oktaycit/CNCRevizyon/Documentation/Media/YerlikayaSürücüler.jpeg

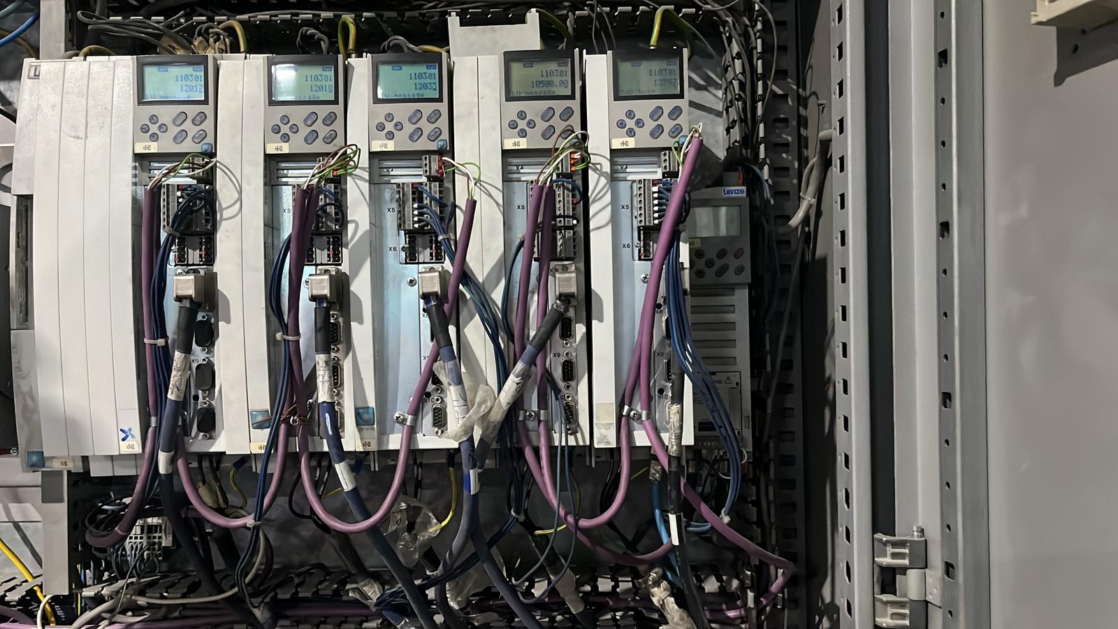
Documentation/Media/YerlikayaSürücüler.jpeg
