oktaycit/CNCRevizyon/Documentation/Media/WhatsApp Image 2026-04-01 at 16.56.13.jpeg

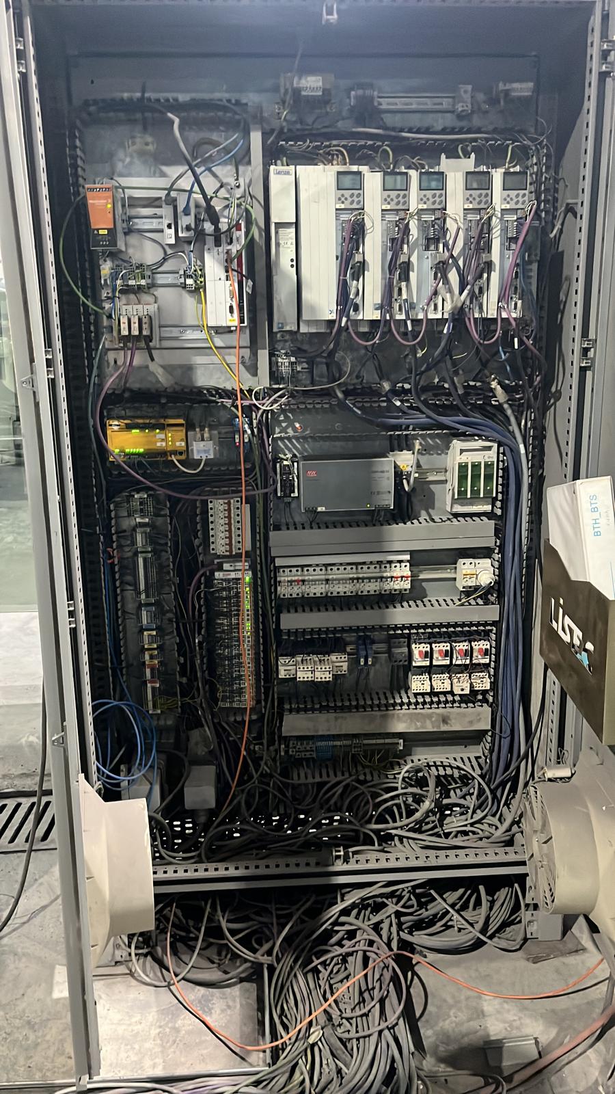
Documentation/Media/WhatsApp Image 2026-04-01 at 16.56.13.jpeg
