oktaycit/CNCRevizyon/Documentation/Reports/Panocu_FreeCAD_Teslim_Notu.md

# Panocu FreeCAD Teslim Notu

**Tarih:** 12.04.2026

Bu teslim iki mekanik gruptan olusur:

1. Ana pano
2. Operator panosu

## Ana Pano

Ana pano icin mevcut elektrik dokumanlarina gore FreeCAD kaynak scripti hazirlanmistir:

- `CAD/FreeCAD/05_Electronics/Main_Panel_Generator.py`
- `CAD/FreeCAD/05_Electronics/README_Main_Panel.md`

Referans mekanik boyutlar:

- `1200 x 2000 x 600 mm`
- montaj plakasi `1000 x 1800 mm`

## Operator Panosu

Operator panosu icin mevcut FreeCAD kaynaklari ve STEP exportlari teslim paketine dahil edilmistir:

- `Operator_Terminal_Generator.py`
- `README_Operator_Terminal.md`
- `DOP-110CS_Housing.stp`
- `DOP-110CS_Panel_Cutout.stp`
- `Operator_Terminal_Enclosure.stp`
- `Operator_Terminal_Door.stp`
- `R1-EC_Mounting_Plate.stp`
- `Cable_Gland_M40.stp`
- `IP65_Vent_Filter.stp`

## Teknik Not

Bu oturumda FreeCAD binary calistirma denemesi `Incompatible processor / neon` hatasi vermistir. Bu nedenle yeni `FCStd` ve ek `STEP` exportlar burada yeniden uretilmemistir; teslim paketi mevcut exportlar + yeni kaynak scriptlerle hazirlanmistir.
