oktaycit/CNCRevizyon/Electrical/Schematics/REVISION_PROGRESS_2026-04-07.md

# GFB60-30RE-S Revizyon 4.1 - Ilerleme Raporu

**Tarih:** 2026-04-08  
**Revizyon:** 4.0 -> 4.1  
**Durum:** ✅ TAMAMLANDI (%100)

---

## Genel Ilerleme Durumu

```text
Revizyon 4.1 Ilerleme Ozeti
├── Sayfa 01: Ana Guc ve 24VDC ............ ✅ %100 TAMAMLANDI
├── Sayfa 02: Emniyet ve STO .............. ✅ %100 TAMAMLANDI
├── Sayfa 03: NC300 ve EtherCAT ........... ✅ %100 TAMAMLANDI
├── Sayfa 04: Servo Suruculer ............. ✅ %100 TAMAMLANDI
├── Sayfa 05: R1-EC I/O ................... ✅ %100 TAMAMLANDI
├── Sayfa 06: Sensorler ................... ✅ %100 TAMAMLANDI
├── Sayfa 07: Aktuatorler ................. ✅ %100 TAMAMLANDI
├── Sayfa 08: Terminal Plani .............. ✅ %100 TAMAMLANDI
├── Sayfa 09: Pin Plani ................... ✅ %100 TAMAMLANDI
└── BOM ................................... ✅ %100 TAMAMLANDI

GENEL ILERLEME: %100 (9/9 sayfa + BOM)
```

---

## Tamamlanan Dosyalar

### DrawIO semalari (12 dosya)

1. `GFB60_30RE_S_Electrical_Rev4.1.drawio`
2. `GFB60_30RE_S_Electrical_Rev4.1_Page02.drawio`
3. `GFB60_30RE_S_Electrical_Rev4.1_Page03.drawio`
4. `GFB60_30RE_S_Electrical_Rev4.1_Page04A.drawio`
5. `GFB60_30RE_S_Electrical_Rev4.1_Page04B.drawio`
6. `GFB60_30RE_S_Electrical_Rev4.1_Page04C.drawio`
7. `GFB60_30RE_S_Electrical_Rev4.1_Page04D.drawio`
8. `GFB60_30RE_S_Electrical_Rev4.1_Page05.drawio`
9. `GFB60_30RE_S_Electrical_Rev4.1_Page06.drawio`
10. `GFB60_30RE_S_Electrical_Rev4.1_Page07.drawio`
11. `GFB60_30RE_S_Electrical_Rev4.1_Page08.drawio`
12. `GFB60_30RE_S_Electrical_Rev4.1_Page09.drawio`

### Destek dokumanlari

- `Electrical/BOM/GFB60-30RE-S_BOM.md`
- `Electrical/WIRING_REFERENCE.md`
- `Electrical/Schematics/REVISION_STATUS.md`
- `Electrical/Schematics/REVISION_SUMMARY.md`
- `Electrical/Schematics/REVISION_SUCCESS_2026-04-07.md`

---

## Ozet

Bu raporun onceki surumunde sayfa 04-C, 04-D ve 05-09 beklemede gorunuyordu. Fiili dosya kontrolunde bu sayfalarin tamamlandigi dogrulanmis ve ilerleme durumu `%100` olarak guncellenmistir.

Kalan adimlar:

- PDF export
- Ic tutarlilik kontrolu
- Final review ve saha onayi
