oktaycit/CNCRevizyon/Electrical/Schematics/REVISION_STATUS.md

# GFB60-30RE-S Revizyon Durum Raporu

**Tarih:** 2026-04-08  
**Revizyon:** 4.0 -> 4.1  
**Durum:** ✅ CIZIM PAKETI TAMAMLANDI (%100)

---

## Genel Ilerleme Durumu

```text
Revizyon 4.1 Ilerleme Ozeti
├── Sayfa 01: Ana Guc ve 24VDC ............ ✅ %100 TAMAMLANDI
├── Sayfa 02: Emniyet ve STO .............. ✅ %100 TAMAMLANDI
├── Sayfa 03: NC300 ve EtherCAT ........... ✅ %100 TAMAMLANDI
├── Sayfa 04: Servo Suruculer ............. ✅ %100 TAMAMLANDI
│   ├── 04-A: X ekseni (4.5kW) ............ ✅ TAMAMLANDI
│   ├── 04-B: Y/ALT eksenleri (2.0kW) ..... ✅ TAMAMLANDI
│   ├── 04-C: Z ekseni (1.0kW, frenli) .... ✅ TAMAMLANDI
│   └── 04-D: CNC ekseni (1.5kW) .......... ✅ TAMAMLANDI
├── Sayfa 05: R1-EC I/O ................... ✅ %100 TAMAMLANDI
├── Sayfa 06: Sensorler ................... ✅ %100 TAMAMLANDI
├── Sayfa 07: Aktuatorler ................. ✅ %100 TAMAMLANDI
├── Sayfa 08: Terminal Plani .............. ✅ %100 TAMAMLANDI
├── Sayfa 09: Pin Plani ................... ✅ %100 TAMAMLANDI
└── BOM ................................... ✅ %100 TAMAMLANDI

GENEL ILERLEME: %100 (9/9 sayfa + BOM)
```

---

## Tamamlanan Isler

### DrawIO sema paketi

- ✅ Sayfa 01: Ana guc, 24VDC dagitimi, EMC, parafudr, faz kontrol
- ✅ Sayfa 02: Emniyet zinciri, E-STOP, safety door, STO dagitimi
- ✅ Sayfa 03: NC300, EtherCAT omurgasi, CN1/CN2/CN3/CN5 detaylari
- ✅ Sayfa 04-A/B/C/D: Tum servo eksenleri, encoder, STO, fren devresi
- ✅ Sayfa 05: R1-EC coupler, DI/DO modulleri, I/O adres tablosu
- ✅ Sayfa 06: Sensor detaylari, M12 pinout, kablo routing, shield
- ✅ Sayfa 07: Aktuator detaylari, role cikislari, sigorta dagitimi
- ✅ Sayfa 08: Terminal plani, tork degerleri, PE bara, test tablosu
- ✅ Sayfa 09: Pin plani, konnektor detaylari, renk kodlari, crimp bilgileri

### Dokumantasyon

- ✅ `Electrical/BOM/GFB60-30RE-S_BOM.md`
- ✅ `Electrical/WIRING_REFERENCE.md`
- ✅ `Electrical/SCHEMATIC_COMPLETION_SUMMARY.md`
- ✅ `Electrical/Schematics/REVISION_ACTION_LIST.md`
- ✅ `Electrical/Schematics/REVISION_SUMMARY.md`
- ✅ `Electrical/Schematics/REVISION_PROGRESS_2026-04-07.md`
- ✅ `Electrical/Schematics/REVISION_SUCCESS_2026-04-07.md`

---

## Dosya Durumu

### DrawIO semalari

```text
Electrical/Schematics/DrawIO_Project/
├── GFB60_30RE_S_Electrical_Rev4.1.drawio
├── GFB60_30RE_S_Electrical_Rev4.1_Page02.drawio
├── GFB60_30RE_S_Electrical_Rev4.1_Page03.drawio
├── GFB60_30RE_S_Electrical_Rev4.1_Page04A.drawio
├── GFB60_30RE_S_Electrical_Rev4.1_Page04B.drawio
├── GFB60_30RE_S_Electrical_Rev4.1_Page04C.drawio
├── GFB60_30RE_S_Electrical_Rev4.1_Page04D.drawio
├── GFB60_30RE_S_Electrical_Rev4.1_Page05.drawio
├── GFB60_30RE_S_Electrical_Rev4.1_Page06.drawio
├── GFB60_30RE_S_Electrical_Rev4.1_Page07.drawio
├── GFB60_30RE_S_Electrical_Rev4.1_Page08.drawio
└── GFB60_30RE_S_Electrical_Rev4.1_Page09.drawio
```

---

## Acik Kalan Konular

Cizim uretimi acisindan acik konu kalmadi. Kalan isler uygulama ve kalite adimlaridir:

- PDF export alinmasi
- Cizim ici son dil ve imla temizligi
- Cross-reference ve terminal numarasi son kontrolu
- Saha validasyonu ve final onay

---

## Sonuc

Revizyon 4.1 elektrik cizim paketi dosya bazinda tamamlanmistir. Onceki `%56`, `%60` ve `%67` ilerleme raporlari artik guncel degildir; bu rapor, fiili dosya durumunu yansitan guncel kayittir.
