oktaycit/CNCRevizyon/Electrical/Schematics/REVISION_SUCCESS_2026-04-07.md

# GFB60-30RE-S Revizyon 4.1 - Basari Raporu

**Tarih:** 2026-04-08  
**Revizyon:** 4.0 -> 4.1  
**Durum:** 🎉 CIZIM PAKETI BASARIYLA TAMAMLANDI (%100)

---

## Basari Ozeti

```text
Tamamlanan kapsam
├── 9/9 revizyon sayfasi
├── 5 eksen servo semalari
├── NC300 + EtherCAT omurgasi
├── R1-EC I/O dagitimi
├── Sensor ve aktuator detaylari
├── Terminal ve pin planlari
└── Tam BOM ve wiring referansi
```

---

## Tamamlanan DrawIO Dosyalari

| # | Dosya | Konu | Durum |
|---|---|---|---|
| 1 | `GFB60_30RE_S_Electrical_Rev4.1.drawio` | Ana guc ve 24VDC | ✅ |
| 2 | `GFB60_30RE_S_Electrical_Rev4.1_Page02.drawio` | Emniyet ve STO | ✅ |
| 3 | `GFB60_30RE_S_Electrical_Rev4.1_Page03.drawio` | NC300 ve EtherCAT | ✅ |
| 4 | `GFB60_30RE_S_Electrical_Rev4.1_Page04A.drawio` | X ekseni | ✅ |
| 5 | `GFB60_30RE_S_Electrical_Rev4.1_Page04B.drawio` | Y/ALT eksenleri | ✅ |
| 6 | `GFB60_30RE_S_Electrical_Rev4.1_Page04C.drawio` | Z ekseni | ✅ |
| 7 | `GFB60_30RE_S_Electrical_Rev4.1_Page04D.drawio` | CNC ekseni | ✅ |
| 8 | `GFB60_30RE_S_Electrical_Rev4.1_Page05.drawio` | R1-EC I/O | ✅ |
| 9 | `GFB60_30RE_S_Electrical_Rev4.1_Page06.drawio` | Sensor detaylari | ✅ |
| 10 | `GFB60_30RE_S_Electrical_Rev4.1_Page07.drawio` | Aktuator detaylari | ✅ |
| 11 | `GFB60_30RE_S_Electrical_Rev4.1_Page08.drawio` | Terminal plani | ✅ |
| 12 | `GFB60_30RE_S_Electrical_Rev4.1_Page09.drawio` | Pin plani | ✅ |

---

## Teknik Kapsam

- ✅ Guc dagitimi ve koruma elemanlari
- ✅ Safety zinciri, STO ve reset mantigi
- ✅ EtherCAT topolojisi ve node zinciri
- ✅ 5 eksen servo baglantilari
- ✅ R1-EC DI/DO adresleme
- ✅ Sensor pinout, routing ve shield sonlandirma
- ✅ Role cikislari ve aktuator devreleri
- ✅ Terminal bloklari, tork degerleri, test noktalari
- ✅ Konnektor pin planlari ve kablo renk kodlari

---

## Kalan Son Adimlar

Cizim uretimi tamamlanmistir. Bundan sonraki adimlar teslim ve kalite odaklidir:

- PDF export alinmasi
- Sayfa 07 icindeki yabanci dil karismis metinlerin temizlenmesi
- Final proofreading
- Saha validasyonu
- Revizyon 4.1 final onayi

---

## Sonuc

Bu raporun onceki surumunde `%67` olarak gorunen ilerleme artik guncel degildir. Revizyon 4.1 sema dosyalari fiilen tamamlanmis oldugu icin bu kayit `%100` olarak guncellenmistir.
