oktaycit/CNCRevizyon/Electrical/Schematics/REVISION_SUMMARY.md

# GFB60-30RE-S Elektrik Semasi Revizyon Ozeti

**Tarih:** 2026-04-08  
**Proje:** CNC Revizyon - Elektrik Semasi Modernizasyonu  
**Hedef:** Delta NC300 + R1-EC EtherCAT tabanli kontrol sistemi

---

## Durum Ozeti

| Kategori | Durum | Tamamlanma | Dokuman |
|---|---|---|---|
| DrawIO Semalar | ✅ Tamam | %100 | Rev 4.1 sayfa 01-09 |
| Teknik Dokuman | ✅ Tamam | %100 | 5 user manual + referanslar |
| I/O Validasyonu | ✅ Tamam | %100 | `WIRING_REFERENCE.md` |
| BOM | ✅ Tamam | %100 | `GFB60-30RE-S_BOM.md` |
| KiCad | ⏳ Baslanmadi | %0 | - |

---

## Uretilen Cizim Kapsami

- ✅ Sayfa 01: Ana guc ve 24VDC dagitimi
- ✅ Sayfa 02: Emniyet zinciri ve STO
- ✅ Sayfa 03: NC300 ve EtherCAT omurgasi
- ✅ Sayfa 04-A/B/C/D: 5 eksen servo suruculer
- ✅ Sayfa 05: R1-EC I/O modulleri
- ✅ Sayfa 06: Sensor detaylari ve routing
- ✅ Sayfa 07: Aktuator detaylari
- ✅ Sayfa 08: Terminal plani
- ✅ Sayfa 09: Pin plani ve konnektor detaylari

---

## Uretilen Ana Dokumanlar

- ✅ `Electrical/WIRING_REFERENCE.md`
- ✅ `Electrical/BOM/GFB60-30RE-S_BOM.md`
- ✅ `Electrical/SCHEMATIC_COMPLETION_SUMMARY.md`
- ✅ `Electrical/Schematics/REVISION_ACTION_LIST.md`
- ✅ `Electrical/Schematics/REVISION_STATUS.md`
- ✅ `Electrical/Schematics/REVISION_PROGRESS_2026-04-07.md`
- ✅ `Electrical/Schematics/REVISION_SUCCESS_2026-04-07.md`

---

## Mevcut Durum Yorumu

Elektrik cizim paketi DrawIO tarafinda tamamlanmis durumdadir. Onceki bazi raporlarda `%40`, `%56`, `%60` ve `%67` gibi ara ilerleme degerleri yer alsa da bunlar fiili dosya durumunun gerisinde kalmistir.

Revizyon 4.1 icin bugun itibariyla dogru ozet:

- DrawIO cizimleri tamam
- BOM tamam
- Wiring referansi tamam
- Final kalite ve saha onayi acik
- KiCad ECAD ortamina gecis isterse ayri faz olarak ele alinmali

---

## Sonraki Adimlar

1. DrawIO dosyalarindan final PDF setini cikarmak
2. Sayfa 07 icindeki dil tutarsizliklarini temizlemek
3. Cross-reference ve terminal numaralarini son kez gozden gecirmek
4. Saha montaj/validasyon ekibiyle final kontrol yapmak
5. Gerekirse KiCad ortamina tasimayi ayri is paketi olarak baslatmak
