oktaycit/CNCRevizyon/Electrical/TAMAMLANAN_ISLEMLER.md

# GFB60/30RE-S - Tamamlanan İşlemler Özeti

**Tarih:** 2026-04-06  
**Durum:** ✅ User Manual'ler İndirildi ve Wiring Referansı Oluşturuldu

---

## 📥 İndirilen Teknik Dokümanlar

Aşağıdaki tüm user manual'ler internetten indirilip `Documentation/Manuals/` klasörüne kaydedildi:

| # | Doküman | Dosya Adı | Boyut | Kaynak |
|---|---|---|---|---|
| 1 | **Delta NC300 CNC Controller** | `Delta_NC300_User_Manual.pdf` | 6.4 MB | deltronics.ru |
| 2 | **Delta ASDA-A3 Servo Drive** | `Delta_ASDA-A3_Servo_Manual.pdf` | 4.7 MB | Scribd |
| 3 | **Delta R1-EC EtherCAT I/O** | `Delta_R1-EC_Manual.pdf` | 2.3 MB | deltronics.ru |
| 4 | **Delta DOP-110CS HMI** | `DOP-110CS_Manual.pdf` | 314 KB | deltronics.ru |
| 5 | **Pilz PNOZ X2.8P Safety** | `Pilz_PNOZ_X2.8P_Manual.pdf` | 378 KB | kempstoncontrols.com |

**Toplam İndirilen:** ~14 MB teknik doküman

---

## 📋 Çıkarılan Teknik Bilgiler

Tüm manual'ler okundu ve aşağıdaki kritik bilgiler çıkarıldı:

### ✅ Delta NC300 CNC Controller
- Güç bağlantıları (24VDC, 2A)
- CN1/CN2 EtherCAT port pinout (RJ45)
- CN3 HMI Ethernet bağlantısı
- CN5 50-pin I/O connector detayları
  - DI_0 - DI_7 (dijital girişler)
  - DO_0 - DO_7 (dijital çıkışlar)
  - AI_0 - AI_3 (analog girişler)
  - AO_0 - AO_1 (analog çıkışlar)
- Grounding gereksinimleri (< 100Ω)

### ✅ Delta ASDA-A3-E Servo Drive
- CN1 50-pin control I/O pinout
  - STO1/STO2 (Safe Torque Off)
  - S-ON (Servo Enable)
  - DI_0 - DI_7 (programmable inputs)
  - DO_1 - DO_5 (programmable outputs)
- CN2 encoder connector (6-pin)
- CN3/CN6 EtherCAT IN/OUT (RJ45)
- Güç bağlantıları:
  - P1: R/S/T (3-faz veya 1-faz)
  - P2: U/V/W (motor)
  - P3/C/D: Rejeneratif direnç
- Z ekseni fren detayları (24VDC, 0.35A)
- Kablo kesitleri ve mesafe limitleri

### ✅ Delta R1-EC I/O Modülleri
- R1-EC01 Bus Coupler wiring
- R1-EC0902D (32-channel DI) terminal planı
  - Giriş spesifikasyonları (24VDC, 5-10mA)
  - NPN/PNP sensör bağlantıları
- R1-EC0902O (32-channel DO relay) terminal planı
  - Röle spesifikasyonları (2A, 250VAC)
  - Valf/aktüatör bağlantıları
- I/O adresleme (%IX0.0 - %IX3.15, %QX0.0 - %QX1.15)

### ✅ Delta DOP-110CS HMI
- Güç bağlantısı (24VDC, 500mA)
- Ethernet port (RJ45, 10/100 Mbps)
- COM1/COM2/COM3 serial port pinout
  - RS232, RS422, RS485 seçenekleri
- Montaj detayları (271x211mm panel cutout)
- Grounding (< 100Ω)

### ✅ Pilz PNOZ X2.8P Safety Relay
- Terminal pinout (A1, A2, S11, S12, S34, S52, 13-14, 23-24, 33-34, 41-42)
- 2-kanallı E-STOP bağlantısı
- Reset butonu wiring
- STO çıkış bağlantıları (tüm eksenler)
- Feedback devresi
- LED göstergeleri

---

## 📄 Oluşturulan Dokümanlar

### 1. WIRING_REFERENCE.md
**Konum:** `Electrical/WIRING_REFERENCE.md`

**İçerik:**
- Tüm cihazların detaylı wiring bilgileri
- Connector pinout tabloları
- I/O dağılımı ve adresleme
- Terminal bloğu planı
- M12 sensör konnektör detayları
- Sigorta ve koruma önerileri
- EtherCAT network topolojisi
- Kablo renk kodları

**Bölümler:**
1. Delta NC300 - Wiring Details
2. Delta ASDA-A3-E - Wiring Details
3. Delta R1-EC - Wiring Details
4. Delta DOP-110CS - Wiring Details
5. Pilz PNOZ X2.8P - Wiring Details
6. Sigorta ve Koruma Önerileri
7. EtherCAT Network Topolojisi
8. Tam I/O Dağılımı
9. Terminal Bloğu Planı (Detaylı)
10. M12 Sensör Konnektör Pinout

### 2. VALIDATION_REPORT.md (Güncellendi)
**Konum:** `Electrical/Schematics/KiCad_Project/VALIDATION_REPORT.md`

**Güncelleme:**
- İndirilen manual'ler eklendi
- Kaynak durumu güncellendi
- Wiring reference dokümanı referans olarak eklendi

---

## 🎯 Sonraki Adımlar

Artık elimizde tüm teknik dokümanlar olduğuna göre, KiCad şemalarını tamamlamaya hazırız:

### Öncelik Sırası:
1. ✅ **Sayfa 01:** Ana Güç ve 24VDC Dağıtımı
   - AC giriş devresi (3-faz 400VAC)
   - Sigorta ve kontaktörler
   - 24V DC power supply
   - X2 dağıtım terminali detayları

2. ✅ **Sayfa 02:** Emniyet Zinciri ve STO
   - Pilz PNOZ X2.8P gerçek bağlantıları
   - E-STOP 2-kanallı devre
   - STO çıkışları (5 eksen)
   - Feedback devresi

3. ✅ **Sayfa 03:** NC300 ve EtherCAT
   - NC300 connector pinout'ları
   - EtherCAT daisy-chain
   - HMI Ethernet
   - I/O bağlantıları

4. ✅ **Sayfa 04:** Servo Sürücüler (5 sayfa)
   - Her eksen için detaylı wiring
   - CN1/CN2/CN3 bağlantıları
   - STO entegrasyonu
   - Z ekseni fren

5. ✅ **Sayfa 05:** R1-EC I/O Modülleri
   - Bus coupler wiring
   - DI/DO modül bağlantıları
   - I/O adresleme

6. ✅ **Sayfa 06-07:** Dijital Giriş/Çıkışlar
   - Sensör bağlantıları
   - Aktüatör devreleri

7. ✅ **Sayfa 08-09:** Terminal ve Pin Planları
   - Detaylı terminal listesi
   - Konnektör pinout tabloları

---

## 💡 Öneri

Şimdi KiCad'de şema çizimine başlayabiliriz. İki seçenek var:

### Seçenek A: Otomatik Şema Oluşturma
Ben sizin için KiCad şema dosyalarını doğrudan düzenleyebilirim:
- Her sayfa için gerçek component'lar eklenir
- Wire bağlantıları çizilir
- Net labels ve power ports yerleştirilir
- ERC check yapılır

### Seçenek B: Manuel Çizim için Talimatlar
Size adım adım talimatlar veririm:
- Hangi component'ları ekleyeceğiniz
- Nasıl bağlayacağınız
- Hangi library'leri kullanacağınız

**Hangi seçeneği tercih edersiniz?**

---

**Hazırlayan:** CNCRevizyon Elektrik Validasyon Ekibi  
**Versiyon:** 2.0  
**Son Güncelleme:** 2026-04-06
