oktaycit/CNCRevizyon/CAD/Reference_Images/00_SUMMARY.md

# Görsel Toplama Özeti - LiSEC GFB 60/30RE-S

## ✅ Oluşturulan Dosyalar

Proje klasörünüzde referans görseller için aşağıdaki yapı oluşturuldu:

```
CAD/Reference_Images/
├── README.md                          # Klasör açıklaması
├── IMAGE_REFERENCE_GUIDE.md           # Detaylı görsel bulma kılavuzu
├── download_images.sh                 # Bash helper script
├── download_reference_images.py       # Python indirme scripti
├── 01_Overall/                        # Genel görünüm (hazır)
├── 02_CuttingHead/                    # Kesim kafası (hazır)
├── 03_Frame/                          # Şase (hazır)
├── 04_LinearGuides/                   # Lineer kılavuzlar (hazır)
├── 05_Motors/                         # Motorlar (hazır)
├── 06_Electronics/                    # Elektronik (hazır)
└── 07_Conveyor/                       # Konveyör (hazır)
```

---

## ⚠️ Web Scraping Sınırlamaları

LiSEC web sitesi ve diğer kaynaklar, otomatik görsel indirmeyi engelleyen güvenlik önlemleri (403 Forbidden, 404 Not Found) uyguluyor. Bu nedenle:

### ✅ Önerilen Yöntem: Manuel İndirme

1. **Aşağıdaki kaynaklardan birini açın:**

   **Google Görseller (En kapsamlı):**
   ```
   https://www.google.com/search?q=LiSEC+GFB+60+30RE+glass+cutting+machine&tbm=isch
   ```

   **Bing Görseller:**
   ```
   https://www.bing.com/images/search?q=LiSEC+GFB+glass+cutting+machine
   ```

   **YouTube (Video'lardan ekran görüntüsü):**
   ```
   https://www.youtube.com/results?search_query=LiSEC+GFB+cutting
   ```

2. **Beğendiğiniz görselleri indirin**
   - Sağ tık → "Resmi farklı kaydet" (Chrome/Firefox)
   - Veya ekran görüntüsü alın (Cmd+Shift+4 macOS'ta)

3. **Uygun klasöre kaydedin:**
   ```
   CAD/Reference_Images/01_Overall/
   CAD/Reference_Images/02_CuttingHead/
   CAD/Reference_Images/03_Frame/
   ...
   ```

---

## 🎯 Aranacak Görsel Listesi

### Öncelik 1: Genel Görünüm (01_Overall)
- [ ] Tam makine izometrik görünüm
- [ ] Ön görünüş (front elevation)
- [ ] Yan görünüş (side elevation)
- [ ] Üst görünüş (top view)

### Öncelik 2: Kesim Kafası (02_CuttingHead)
- [ ] Üst kafa (VB) yakın plan
- [ ] Alt kafa (NB) yakın plan
- [ ] Z ekseni mekanizması
- [ ] Kesim tekeri montajı

### Öncelik 3: Mekanik Detaylar (03_Frame, 04_LinearGuides)
- [ ] Köprü profil yapısı
- [ ] Lineer ray montajı
- [ ] Köşe takviyeleri
- [ ] Ayaklar ve destekler

### Öncelik 4: Elektronik (05_Motors, 06_Electronics)
- [ ] Servo motorlar
- [ ] Kontrol paneli
- [ ] Elektrik kabinetı

---

## 📸 Ekran Görüntüsü Alma (macOS)

```
Cmd + Shift + 4    : Seçili alanı kaydet
Cmd + Shift + 3    : Tam ekran kaydet
Cmd + Shift + 5    : Ekran görüntüsü araçları
```

iPad veya iPhone kullanıyorsanız:
- AirDrop ile Mac'e aktarın
- Reference_Images klasörüne kaydedin

---

## 🔄 Python Script Kullanımı (URL'leriniz Hazırsa)

Eğer görsel URL'lerini manuel olarak bulduysanız, Python script'ini kullanabilirsiniz:

1. **Script'i düzenleyin:**
   ```bash
   # download_reference_images.py dosyasını açın
   # IMAGE_URLS sözlüğündeki boş listeleri doldurun
   ```

2. **Örnek:**
   ```python
   IMAGE_URLS = {
       "01_Overall": [
           "https://ornek.com/lisec-gfb-on.jpg",
           "https://ornek.com/lisec-gfb-yan.jpg",
       ],
       "02_CuttingHead": [
           "https://ornek.com/cutting-head-upper.jpg",
       ],
   }
   ```

3. **Çalıştırın:**
   ```bash
   cd /Users/oktaycit/Projeler/CNCRevizyon/CAD/Reference_Images
   python3 download_reference_images.py
   ```

---

## 📊 İlerleme Takibi

Toplam hedef: ~20-30 referans görsel

| Kategori | Hedef | İndirilen | Durum |
|---|---|---|---|
| 01_Overall | 4-6 | 0 | ⏳ Beklemede |
| 02_CuttingHead | 4-6 | 0 | ⏳ Beklemede |
| 03_Frame | 3-4 | 0 | ⏳ Beklemede |
| 04_LinearGuides | 3-4 | 0 | ⏳ Beklemede |
| 05_Motors | 2-3 | 0 | ⏳ Beklemede |
| 06_Electronics | 2-3 | 0 | ⏳ Beklemede |
| 07_Conveyor | 2-3 | 0 | ⏳ Beklemede |

---

## 🎯 Sonraki Adımlar

1. **Yukarıdaki kaynaklardan görselleri indirin**
2. **İlgili klasörlere kaydedin**
3. **FreeCAD'de Image Workbench ile import edin**
4. **Ölçek referansı verin (6000 mm çalışma alanı)**
5. **Üzerinden geçerek (trace) 3D model oluşturun**

---

## 💡 İpuçları

- **Yüksek çözünürlük** tercih edin (en az 1920x1080)
- **Farklı açılardan** görseller toplayın
- **Ölçek referansı** olacak nesneler içeren görseller seçin
- **Video thumbnail'leri** de faydalı olabilir
- **Teknik çizimler** varsa öncelik verin

---

**Güncelleme:** 2026-04-19
**Durum:** Klasör yapısı hazır, görseller manuel indirilmeyi bekliyor
