oktaycit/CNCRevizyon/Delivery/SolidWorks_Import_2026-04-12/README_SOLIDWORKS_IMPORT.md

# SolidWorks Import Paketi

**Tarih:** 12.04.2026  
**Proje:** LiSEC GFB-60/30RE

Bu paket, panocu veya mekanik tasarimcinin mevcut FreeCAD tabanli parcalari SolidWorks'e aktarabilmesi icin hazirlanmistir.

## Paket Yapisi

### Operator Panel

Bu klasorde SolidWorks'e dogrudan import edilebilecek STEP dosyalari bulunur:

- `DOP-110CS_Housing.stp`
- `DOP-110CS_Panel_Cutout.stp`
- `Operator_Terminal_Enclosure.stp`
- `Operator_Terminal_Door.stp`
- `R1-EC_Mounting_Plate.stp`
- `Cable_Gland_M40.stp`
- `IP65_Vent_Filter.stp`

Ek olarak:

- `Operator_Terminal_Generator.py`
- `README_Operator_Terminal.md`
- `OPERATOR_TERMINAL_IMALAT_BRIEF.md`

## Ana Pano

Ana pano icin bu teslimde:

- `Main_Panel_Generator.py`
- `README_Main_Panel.md`

dosyalari verilmistir.

## Onemli Teknik Not

Bu oturumda FreeCAD runtime `Incompatible processor / neon` hatasi verdigi icin:

- yeni `FCStd` dosyalari
- yeni ana pano STEP exportlari
- ayakli operator terminalin guncel STEP exportlari

burada yeniden olusturulamamistir.

Bu nedenle mevcut STEP dosyalari son uretilmis versiyonlardir; kaynak FreeCAD scriptleri ise daha guncel tasarim niyetini yansitir.

## SolidWorks Import Onerisi

1. STEP dosyalarini `Import as solid body` ile acin
2. Operator paneli icin montaji `Assembly` icinde yeniden kurun
3. Ayakli yeni form gerekiyorsa `Operator_Terminal_Generator.py` referansina gore yeniden modelleyin
4. Ana pano icin `Main_Panel_Generator.py` ve `01_PANEL_LAYOUT.md` referans alin

## Tasarim Niyeti

Operator terminal:

- Beckhoff benzeri ayakli, sade, ince cerceveli
- LiSEC saha ergonomisine uygun
- koprunun home noktalarina yakin kullanima uygun
