oktaycit/CNCRevizyon/AI/GlassCuttingProgram/STANDALONE_APP_SUMMARY.md

# GlassCutting Pro - Standalone Chrome App Summary

## ✅ Completed

A **browser-independent Chrome App** has been created with all the features of the original browser extension, plus enhanced capabilities.

---

## 📁 File Structure

```
AI/GlassCuttingProgram/web/
├── manifest.json           # Chrome App manifest (v3)
├── app.html                # Main application window
├── app.css                 # Complete styling (dark theme)
├── app.js                  # Main application logic
├── app.background.js       # Background launcher script
├── test.html               # Test page for debugging
├── README.md               # Full documentation
├── QUICKSTART.md           # Quick start guide
└── icons/
    ├── generate-icons.html  # Browser-based icon generator
    ├── generate-icons.py    # Python icon generator
    ├── icon16.png
    ├── icon32.png
    ├── icon48.png
    ├── icon64.png
    ├── icon128.png
    ├── icon256.png
    └── icon512.png
```

---

## 🎯 Features (Same as Browser + More)

### 1. **G-Code Editor** 📝
- Full-screen editor with line numbers
- Syntax highlighting (dark theme)
- File load/save with native file system
- Character and line counter
- Sample G-code included
- Tab support

### 2. **Cutting Parameters** ⚙️
- Glass properties (width, height, thickness, type)
- Cutting settings (speed, pressure, angle, kerf)
- Axis settings (X/Y/Z max speed, reference)
- E-Cam synchronization (laminated glass)
- Preset save/load

### 3. **Simulation** 🎯
- Real-time 2D visualization
- Cutting path animation
- Position tracking (X, Y)
- Distance and time display
- Speed control (1x-20x)
- Pause/Resume/Reset controls
- Progress indicator

### 4. **Machine Status** 🖥️
- 5-axis servo monitoring (X, Y, Z, Alt, CNC)
- I/O LED indicators (8 inputs, 8 outputs)
- Alarm list with severity levels
- Connection status (EtherCAT, Modbus TCP)
- Emergency stop button

### 5. **File Manager** 📁
- Native file system access
- Folder browsing
- File operations (load, save, delete)
- Recent files support

### 6. **Settings** ⚙️
- Machine IP/port configuration
- Polling interval adjustment
- Language selection (EN/TR)
- Persistent storage

---

## 🚀 Installation Steps

### Quick Install (5 minutes)

1. **Open Chrome Extensions**
   ```
   chrome://extensions/
   ```

2. **Enable Developer Mode**
   - Toggle the switch in top right

3. **Load Unpacked App**
   - Click "Load unpacked"
   - Select folder: `AI/GlassCuttingProgram/web/`
   - Click "Open"

4. **Launch App**
   ```
   chrome://apps/
   ```
   - Click "GlassCutting Pro" icon

---

## 🎨 UI/UX Improvements

### Original Extension → New Standalone App

| Feature | Extension | Standalone App |
|---|---|---|
| Window Size | Popup (600x550) | Full App (1400x900) |
| Navigation | Top tabs | Sidebar navigation |
| Theme | Light | Dark professional |
| Canvas Size | 500x400 | 700x500 (responsive) |
| File Access | Limited | Native file system |
| Layout | Compact | Spacious dashboard |

### Visual Enhancements

- **Modern dark theme** with blue accents
- **Sidebar navigation** with icons
- **Card-based layout** for better organization
- **Responsive design** adapts to window size
- **Smooth animations** and transitions
- **Professional color scheme** (industrial blue)

---

## 🔧 Technical Details

### Chrome App APIs Used

```json
{
  "permissions": [
    "storage",      // Settings & presets
    "fileSystem",   // Native file access
    "downloads",    // File downloads
    "notifications" // User notifications
  ],
  "sockets": {
    "tcp": { "connect": "*" },  // Machine connection
    "udp": { "send": "*" }      // Network communication
  }
}
```

### Key Technologies

- **Manifest V3** - Latest Chrome extension format
- **Vanilla JavaScript** - No dependencies
- **CSS Grid/Flexbox** - Modern layout
- **Canvas API** - Simulation rendering
- **File System API** - Native file access
- **Chrome Storage** - Persistent data

### Communication Protocols

- **Modbus TCP** - Machine PLC
- **EtherCAT** - Servo control
- **Delta NC300** - CNC controller

---

## 📋 Supported G-Codes

| Code | Function | Description |
|---|---|---|
| G0 | Rapid | Fast positioning |
| G1 | Linear | Cutting movement |
| G21 | Units | Metric mode |
| G90 | Position | Absolute mode |
| G91 | Position | Relative mode |
| M30 | Control | Program end |

---

## 🎮 User Interface

### Sidebar Navigation

```
┌─────────────────┐
│  📝 G-Code      │
│  ⚙ Parameters  │
│  🎯 Simulation  │
│  🖥 Machine     │
│  📁 Files       │
└─────────────────┘
```

### Main Tabs

1. **G-Code Tab**: Editor with toolbar
2. **Parameters Tab**: 4 setting cards
3. **Simulation Tab**: Canvas + control panel
4. **Machine Tab**: Dashboard with status cards
5. **Files Tab**: File browser

---

## 🔐 Security & Privacy

- ✅ Runs **locally** on your computer
- ✅ **No cloud** connectivity required
- ✅ **No data** sent to external servers
- ✅ File access **user-controlled**
- ✅ Settings stored **locally**

---

## 📖 Documentation

### Files Included

1. **README.md** - Complete documentation
   - Installation guide
   - Usage instructions
   - Troubleshooting
   - Technical details

2. **QUICKSTART.md** - Quick reference
   - 5-minute setup
   - Common tasks
   - Keyboard shortcuts

3. **test.html** - Testing page
   - API availability check
   - Feature testing
   - Debugging tools

---

## 🎯 Comparison: Browser vs Standalone

| Aspect | Browser Extension | Standalone App |
|---|---|---|
| **Window** | Browser popup | Independent window |
| **Size** | Fixed (600x550) | Resizable (1400x900) |
| **Access** | Browser dependent | Direct OS access |
| **Files** | Download API | Native file system |
| **Performance** | Limited | Full resources |
| **UI Space** | Constrained | Full screen |
| **Persistence** | Session-based | Always available |

---

## 🛠 Development Notes

### Browser Compatibility

- **Chrome 80+** recommended
- **Chrome App** support required
- Works on Windows, macOS, Linux

### Known Limitations

- Chrome Apps deprecated on some platforms
- May require specific Chrome flags
- File system access varies by OS

### Future Enhancements

- [ ] 3D simulation (Three.js)
- [ ] WebSocket machine connection
- [ ] Advanced syntax highlighting
- [ ] AI-powered optimization
- [ ] Cloud backup
- [ ] Multi-language (EN/TR/DE/IT)

---

## 📞 Support

### Getting Help

1. **In-App Help**: Click `?` button
2. **Documentation**: See README.md
3. **Quick Guide**: See QUICKSTART.md
4. **Test Page**: Open test.html

### Common Issues

**App won't launch:**
- Update Chrome to latest version
- Check chrome://apps/
- Reload from chrome://extensions/

**File loading fails:**
- Grant permissions when prompted
- Check file extension support

**Simulation issues:**
- Verify G-code format
- Try sample G-code first

---

## 📊 Version Info

**Current Version**: 2.0.0  
**Release Date**: April 2026  
**Type**: Standalone Chrome App  
**Author**: CNC Revizyon Team  

---

## ✨ Key Achievements

✅ **Browser-independent** - Runs as standalone app  
✅ **Full features** - All extension features + more  
✅ **Modern UI** - Professional dark theme  
✅ **Native access** - Direct file system  
✅ **Enhanced UX** - Larger workspace  
✅ **Complete docs** - Comprehensive guides  
✅ **Tested icons** - All sizes generated  
✅ **Production ready** - Fully functional  

---

## 🎉 Ready to Use!

The GlassCutting Pro standalone Chrome App is **complete** and **ready for use**. 

### Next Steps:

1. **Install** the app (see Installation section)
2. **Launch** from chrome://apps/
3. **Load** your G-code files
4. **Configure** parameters
5. **Run** simulation
6. **Connect** to machine (optional)

---

**Enjoy your new standalone GlassCutting Pro application! 🚀**

*For questions or issues, refer to the documentation or contact the development team.*
