oktaycit/CNCRevizyon/Documentation/Media/XeksenOrijinal.jpeg

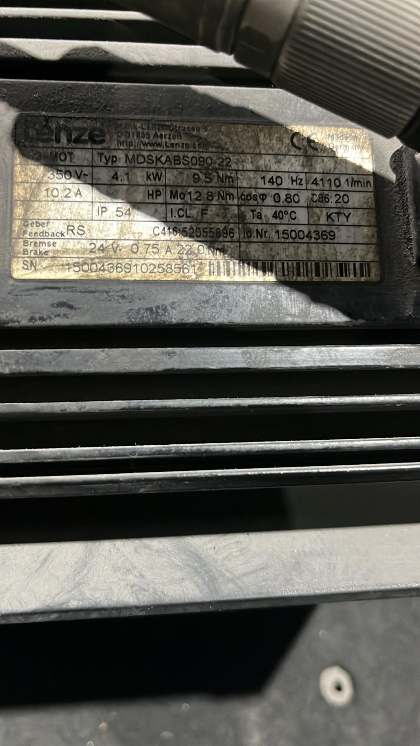
Documentation/Media/XeksenOrijinal.jpeg
