oktaycit/CNCRevizyon/Documentation/Media/YeksenOrjinal.jpeg

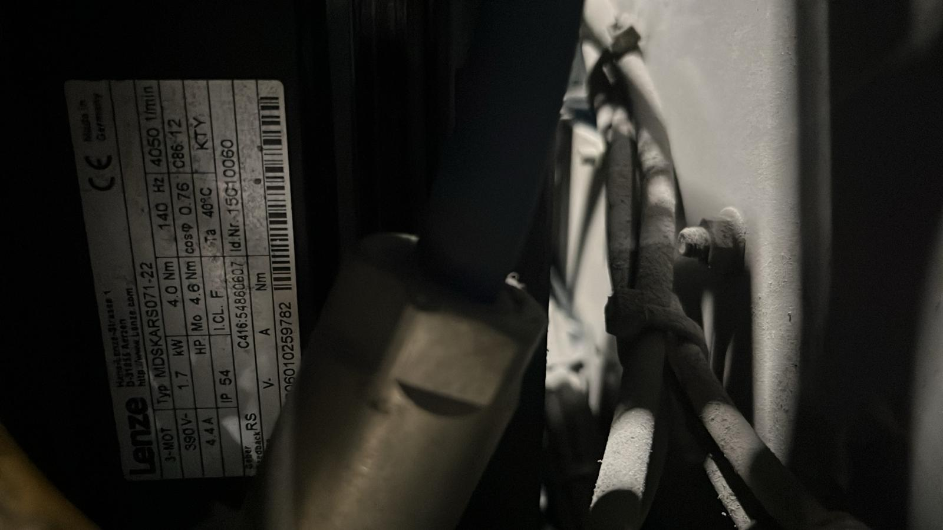
Documentation/Media/YeksenOrjinal.jpeg
