oktaycit/CNCRevizyon/Documentation/Media/ZeksenOrijinal.jpeg

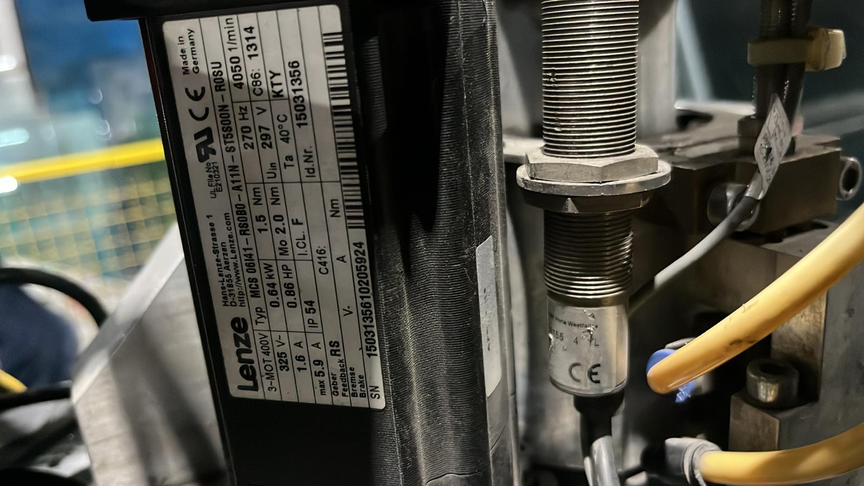
Documentation/Media/ZeksenOrijinal.jpeg
