oktaycit/CNCRevizyon/CAD/FreeCAD/07_Exports/STEP/Assembly/XAxis_Assembly.stp

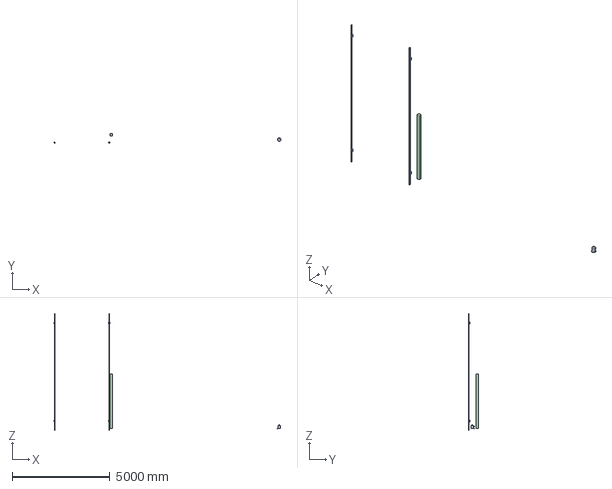
[picture p6: CAD file, 2026-04-13]
CAD/FreeCAD/07_Exports/STEP/Assembly/XAxis_Assembly.stp
11620.0 x 520.0 x 6000.0 mm
