oktaycit/CNCRevizyon/CAD/FreeCAD/07_Exports/STEP/Frame/MainFrame_Profiles.stp

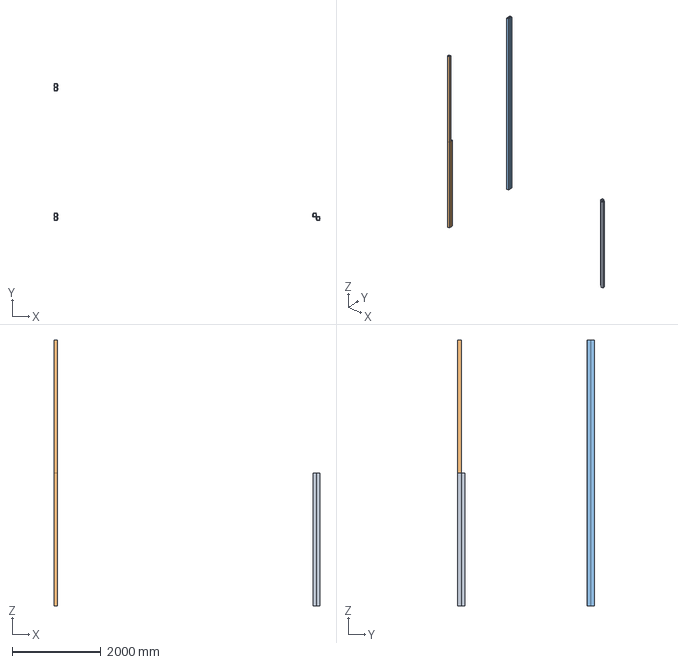
[picture p7: CAD file, 2026-04-13]
CAD/FreeCAD/07_Exports/STEP/Frame/MainFrame_Profiles.stp
6000.0 x 3080.0 x 6000.0 mm
