oktaycit/CNCRevizyon/CAD/FreeCAD/07_Exports/STEP/LinearGuides/HIWIN_HGH25_Assembly.stp

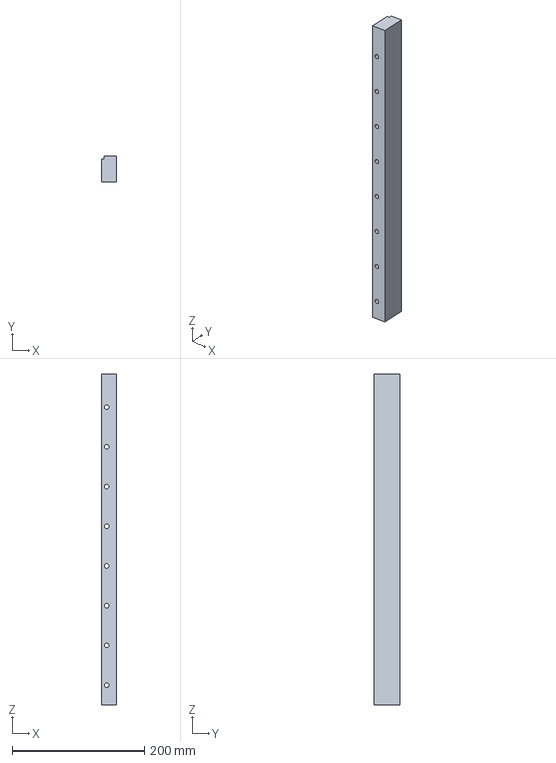
[picture p8: CAD file, 2026-04-13]
CAD/FreeCAD/07_Exports/STEP/LinearGuides/HIWIN_HGH25_Assembly.stp
23.0 x 40.0 x 500.0 mm
