oktaycit/CNCRevizyon/Delivery/Panocu_FreeCAD_2026-04-12/07_Exports/STEP/Electronics/Main_Panel_Body.stp

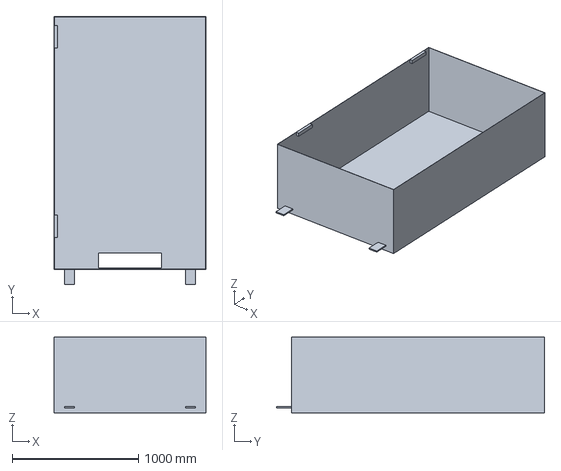
[picture p9: CAD file, 2026-04-13]
Delivery/Panocu_FreeCAD_2026-04-12/07_Exports/STEP/Electronics/Main_Panel_Body.stp
1200.0 x 2120.0 x 600.0 mm
