oktaycit/CNCRevizyon/CAD/FreeCAD/07_Exports/STEP/Assembly/ZAxis_Assembly.stp

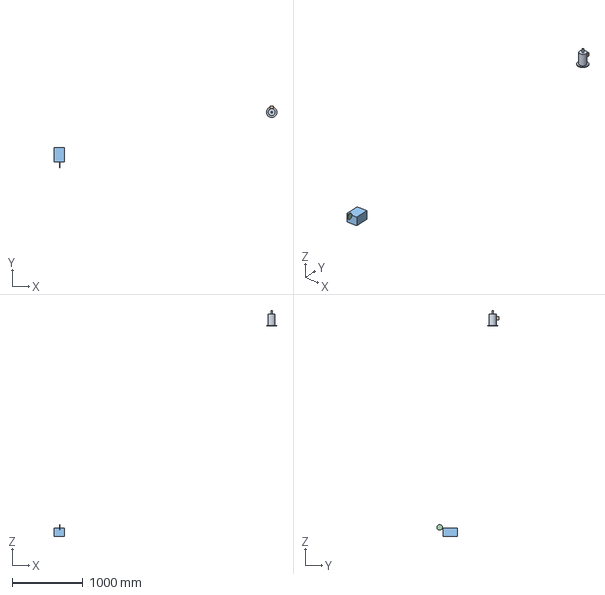
[picture p10: CAD file, 2026-04-13]
CAD/FreeCAD/07_Exports/STEP/Assembly/ZAxis_Assembly.stp
3150.0 x 880.0 x 3195.0 mm
