oktaycit/CNCRevizyon/Delivery/Panocu_FreeCAD_2026-04-12/07_Exports/STEP/Electronics/Main_Panel_Mounting_Plate.stp

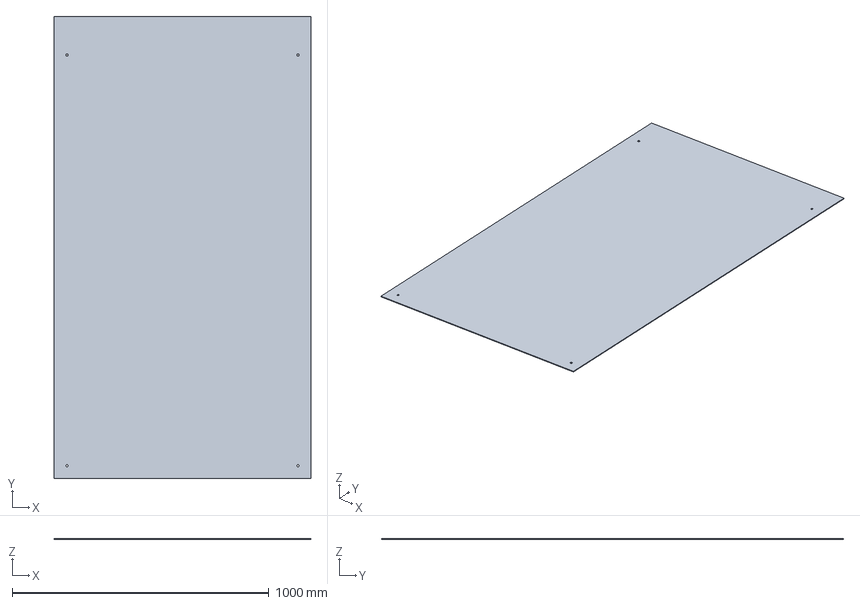
[picture p11: CAD file, 2026-04-13]
Delivery/Panocu_FreeCAD_2026-04-12/07_Exports/STEP/Electronics/Main_Panel_Mounting_Plate.stp
1000.0 x 1800.0 x 3.00 mm
