oktaycit/CNCRevizyon/CAD/FreeCAD/07_Exports/STEP/Assembly/YAxis_Assembly.stp

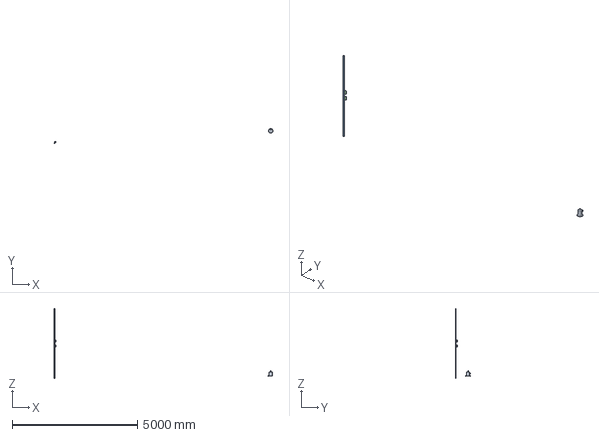
[picture p12: CAD file, 2026-04-13]
CAD/FreeCAD/07_Exports/STEP/Assembly/YAxis_Assembly.stp
8730.0 x 616.5 x 2800.0 mm
