oktaycit/CNCRevizyon/Delivery/Panocu_FreeCAD_2026-04-12/07_Exports/STEP/Electronics/Main_Panel_Door.stp

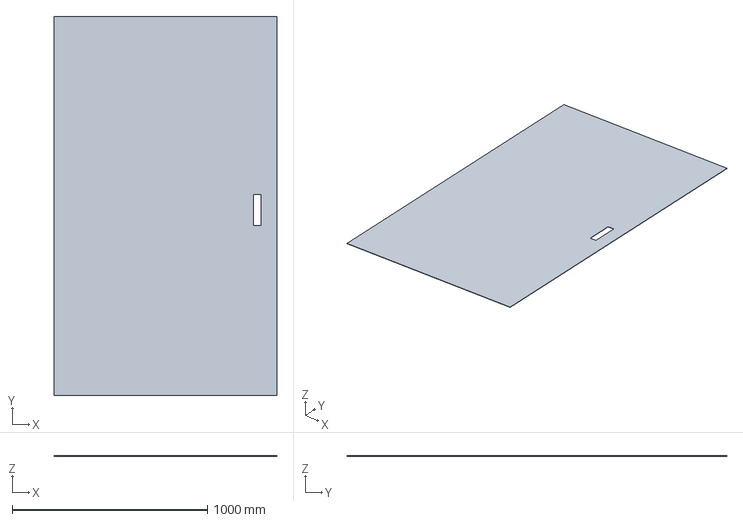
[picture p13: CAD file, 2026-04-13]
Delivery/Panocu_FreeCAD_2026-04-12/07_Exports/STEP/Electronics/Main_Panel_Door.stp
1140.0 x 1940.0 x 2.00 mm
