oktaycit/CNCRevizyon/CAD/FreeCAD/07_Exports/STEP/Electronics/Operator_Terminal_Complete.stp

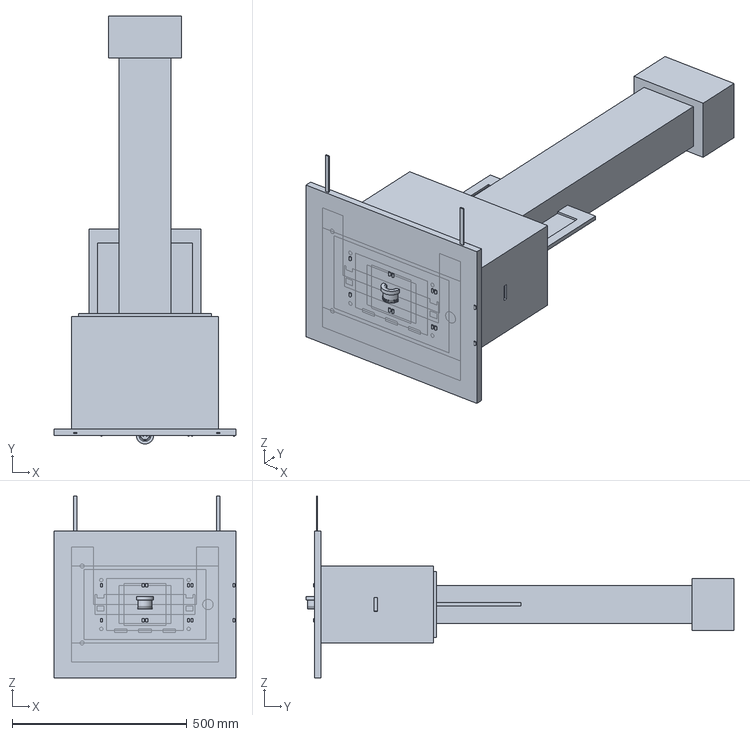
[picture p14: CAD file, 2026-04-13]
CAD/FreeCAD/07_Exports/STEP/Electronics/Operator_Terminal_Complete.stp
520.0 x 1225.0 x 520.0 mm
