oktaycit/CNCRevizyon/CAD/FreeCAD/07_Exports/STEP/Assembly/Full_Machine_Assembly.stp

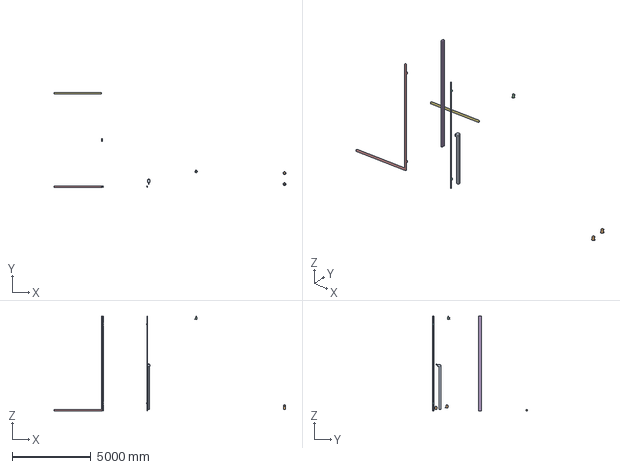
[picture p15: CAD file, 2026-04-13]
CAD/FreeCAD/07_Exports/STEP/Assembly/Full_Machine_Assembly.stp
14690.0 x 6000.0 x 6015.0 mm
