oktaycit/CNCRevizyon/CAD/FreeCAD/07_Exports/STEP/CuttingHead/Cutting_Head_Assembly.stp

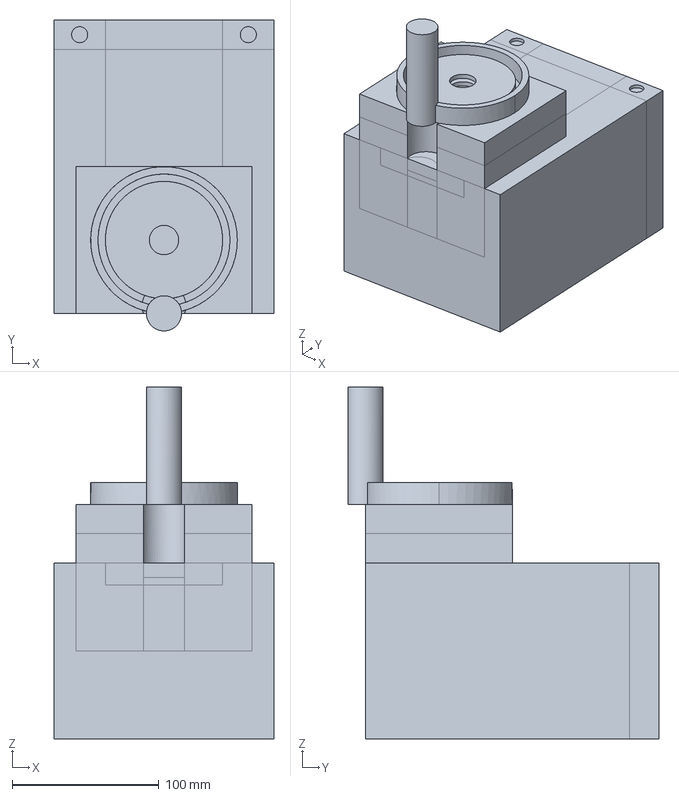
[picture p16: CAD file, 2026-04-13]
CAD/FreeCAD/07_Exports/STEP/CuttingHead/Cutting_Head_Assembly.stp
150.0 x 212.0 x 240.0 mm
