oktaycit/CNCRevizyon/CAD/FreeCAD/07_Exports/STEP/Electronics/Main_Panel_Door.stp

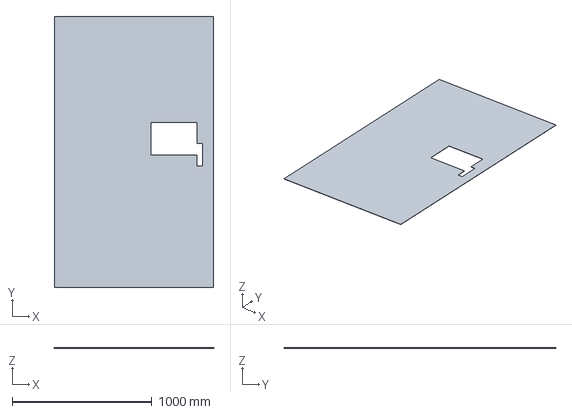
[picture p17: CAD file, 2026-04-13]
CAD/FreeCAD/07_Exports/STEP/Electronics/Main_Panel_Door.stp
1140.0 x 1940.0 x 2.00 mm
