oktaycit/CNCRevizyon/CAD/30RE-S Hibrit Sistem.FCStd

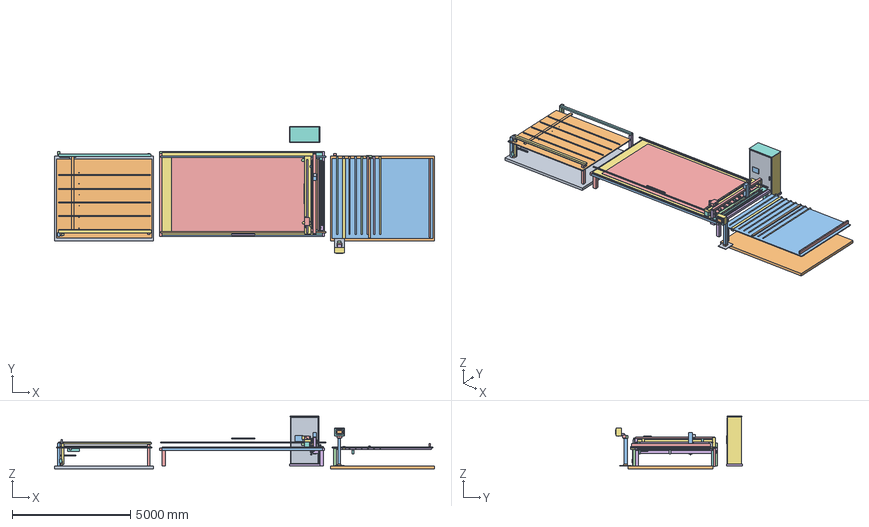
[picture p18: CAD file, 2026-04-20]
CAD/30RE-S Hibrit Sistem.FCStd
16100.0 x 5394.0 x 2225.0 mm
Loading_Station_Base
Loading_Station_Deck
Loading_Station_Tower_Left
Loading_Station_Tower_Right
Loading_Station_Back_Tower_Left
Loading_Station_Back_Tower_Right
Loading_Station_Upper_Frame
Loading_Station_Side_Beam
Loading_Station_Brace_Left
Loading_Station_Brace_Right
Loading_Station_Storage_Rib_1
Loading_Station_Storage_Rib_2
Loading_Station_Storage_Rib_3
Loading_Station_Storage_Rib_4
Loading_Station_Storage_Rib_5
Loading_Station_Carriage
Loading_Suction_Beam
Loading_Vacuum_Manifold
Loading_Suction_Pad_1_1
Loading_Suction_Pad_1_2
Loading_Suction_Pad_2_1
Loading_Suction_Pad_2_2
Loading_Suction_Pad_3_1
Loading_Suction_Pad_3_2
Loading_Suction_Pad_4_1
Loading_Suction_Pad_4_2
Loading_Suction_Pad_5_1
Loading_Suction_Pad_5_2
Loading_Suction_Pad_6_1
Loading_Suction_Pad_6_2
Loading_Chain_Column
Loading_Station_Drive_Motor
Loading_Guide_Roller_Top
Loading_Guide_Roller_Bottom
Frame_Left_Rail
Frame_Right_Rail
Frame_Front_Beam
Frame_Back_Beam
Table_Grid_Left_Deck
Table_Grid_Right_Deck
Table_Grid_VB_Slot
Table_Grid_VB_Slot_Left_Edge
Table_Grid_VB_Slot_Right_Edge
Table_Grid_VB_Slot_Top_Marker
Glass_Sheet_Reference
Lower_Cutter_Channel_Reference
Gantry_White_Bridge
Gantry_White_Left_Support
Gantry_White_Right_Support
X_Rail_Left
X_Rail_Right
Motor_X_Left
Gantry_White_Y_Axis
Y_Rail
Motor_Y
Z_Column
Z_Carriage
Cutting_Head
Cutting_Wheel
Motor_Z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
