oktaycit/CNCRevizyon/CAD/FreeCAD/07_Exports/STEP/CuttingHead/Glass_Edge_Deletion_Head.stp

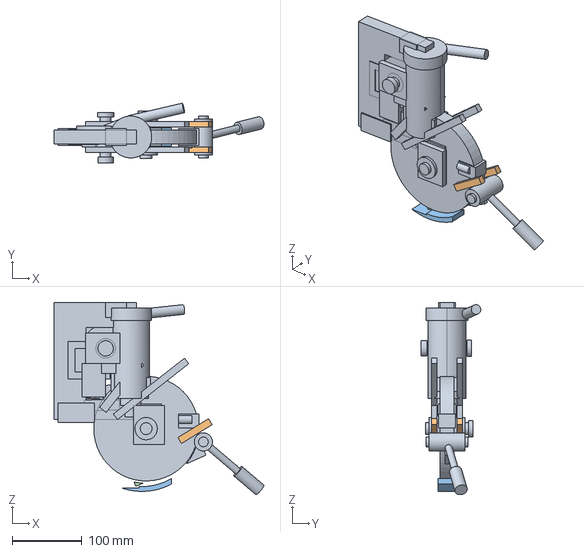
[picture p20: CAD file, 2026-04-20]
CAD/FreeCAD/07_Exports/STEP/CuttingHead/Glass_Edge_Deletion_Head.stp
300.8 x 85.5 x 275.7 mm
