oktaycit/CNCRevizyon/CAD/FreeCAD/07_Exports/STEP/Electronics/Control_Panel_Box.stp

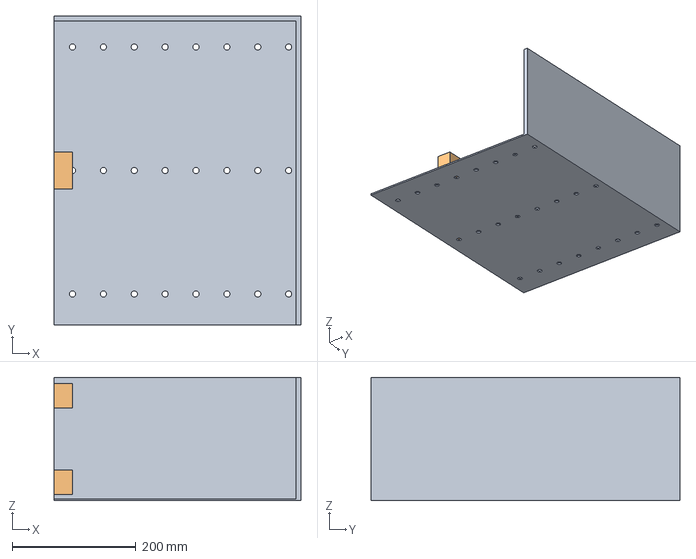
[picture p21: CAD file, 2026-04-13]
CAD/FreeCAD/07_Exports/STEP/Electronics/Control_Panel_Box.stp
400.0 x 500.0 x 200.0 mm
