oktaycit/CNCRevizyon/CAD/FreeCAD/07_Exports/STEP/Motors/ECMA-C11010.stp

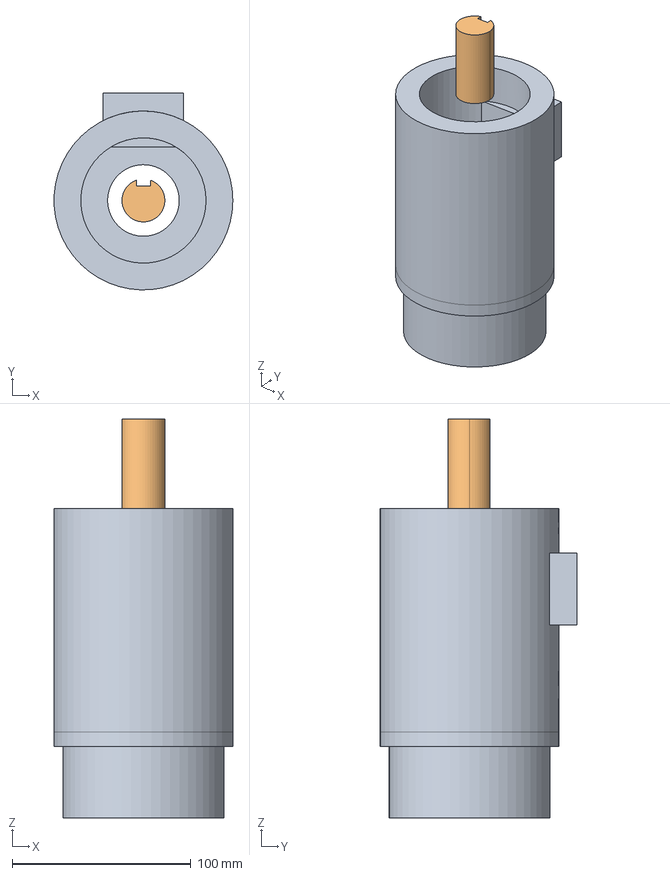
[picture p22: CAD file, 2026-04-13]
CAD/FreeCAD/07_Exports/STEP/Motors/ECMA-C11010.stp
99.9 x 110.0 x 223.0 mm
