oktaycit/CNCRevizyon/Delivery/Panocu_FreeCAD_2026-04-12/Operator_Panel/R1-EC_Mounting_Plate.stp

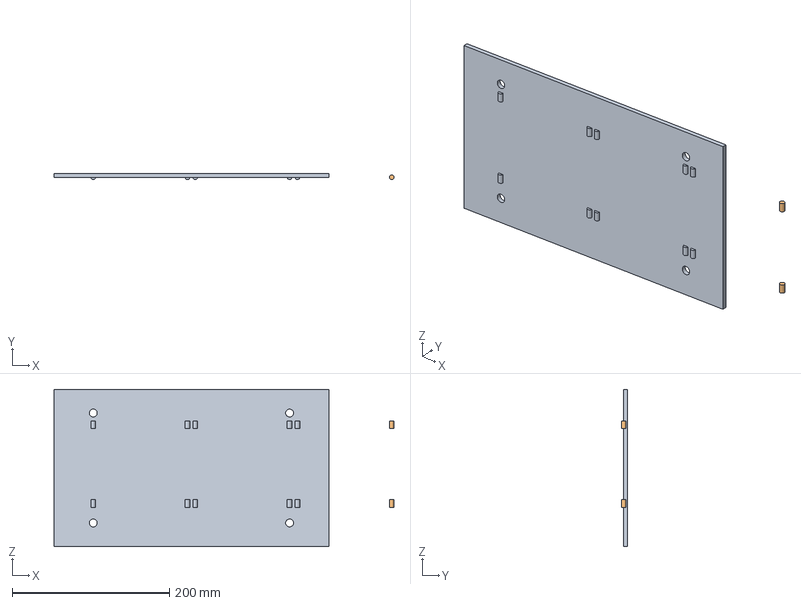
[picture p23: CAD file, 2026-04-07]
Delivery/Panocu_FreeCAD_2026-04-12/Operator_Panel/R1-EC_Mounting_Plate.stp
433.0 x 8.00 x 200.0 mm
