oktaycit/CNCRevizyon/CAD/FreeCAD/07_Exports/STEP/CuttingHead/ZAxis_Slide.stp

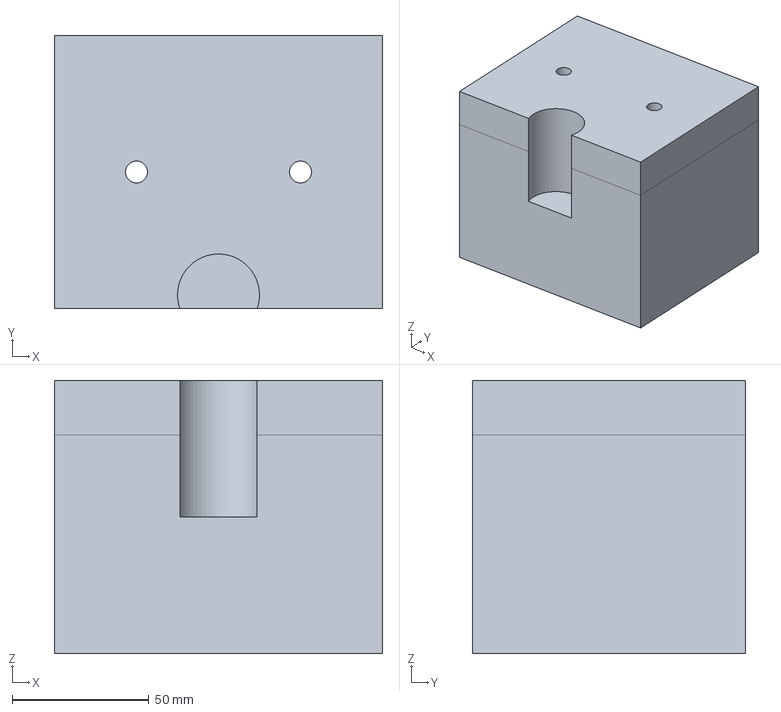
[picture p24: CAD file, 2026-04-13]
CAD/FreeCAD/07_Exports/STEP/CuttingHead/ZAxis_Slide.stp
120.0 x 100.0 x 100.0 mm
