oktaycit/CNCRevizyon/CAD/FreeCAD/07_Exports/STEP/Electronics/Sensor_Bracket_Proximity.stp

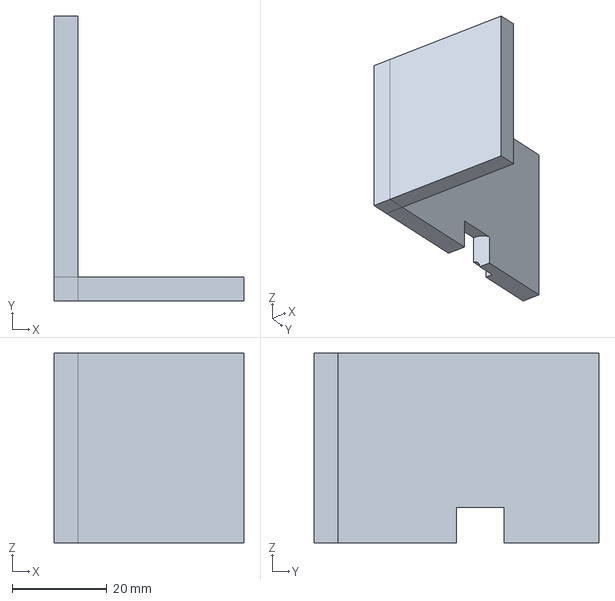
[picture p25: CAD file, 2026-04-13]
CAD/FreeCAD/07_Exports/STEP/Electronics/Sensor_Bracket_Proximity.stp
40.0 x 60.0 x 40.0 mm
