oktaycit/CNCRevizyon/CAD/FreeCAD/07_Exports/STEP/LinearGuides/HIWIN_HGH25_Block.stp

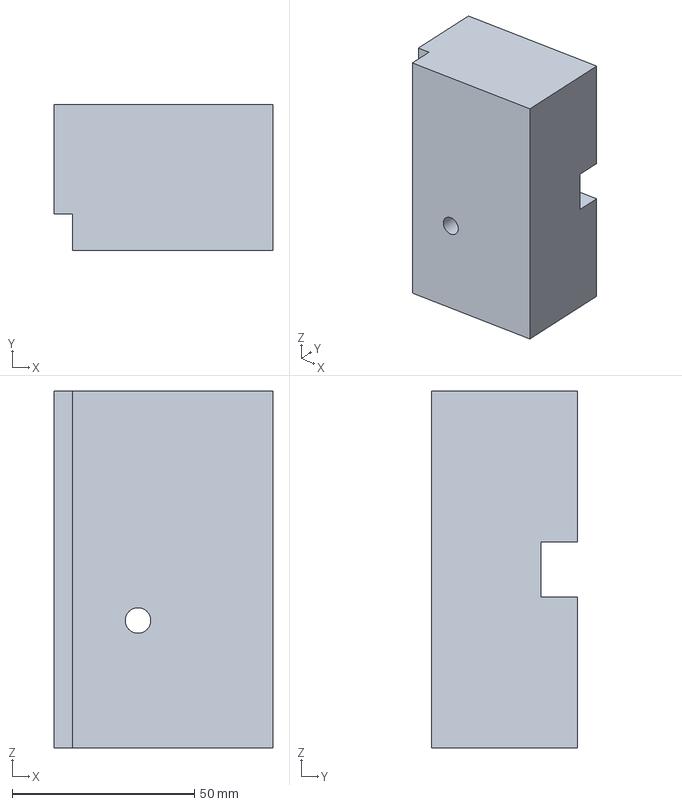
[picture p26: CAD file, 2026-04-13]
CAD/FreeCAD/07_Exports/STEP/LinearGuides/HIWIN_HGH25_Block.stp
60.0 x 40.0 x 98.0 mm
