oktaycit/CNCRevizyon/CAD/FreeCAD/07_Exports/STEP/Motors/ECMA-L11845.stp

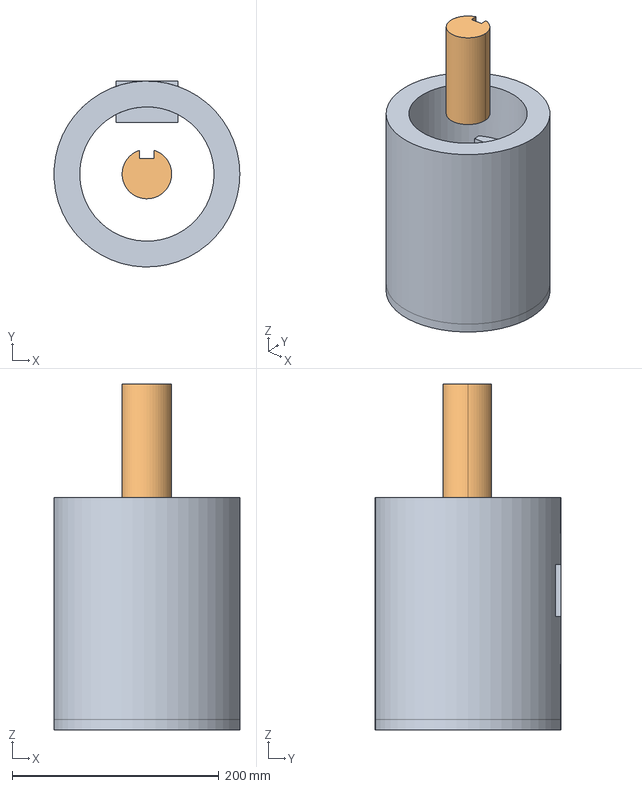
[picture p27: CAD file, 2026-04-13]
CAD/FreeCAD/07_Exports/STEP/Motors/ECMA-L11845.stp
179.8 x 180.0 x 335.0 mm
