oktaycit/CNCRevizyon/Delivery/SolidWorks_Import_2026-04-12/Operator_Panel/DOP-110CS_Housing.stp

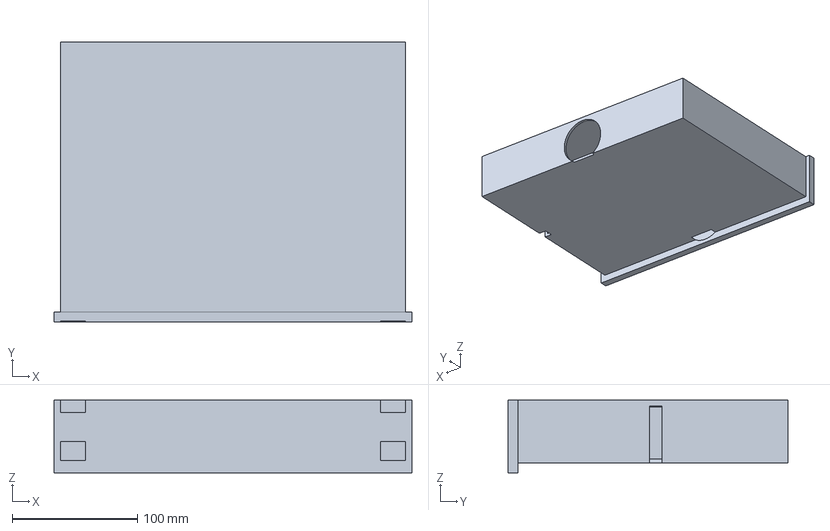
[picture p28: CAD file, 2026-04-07]
Delivery/SolidWorks_Import_2026-04-12/Operator_Panel/DOP-110CS_Housing.stp
286.0 x 224.0 x 58.0 mm
