oktaycit/CNCRevizyon/CAD/FreeCAD/07_Exports/STEP/CuttingHead/Cutting_Wheel.stp

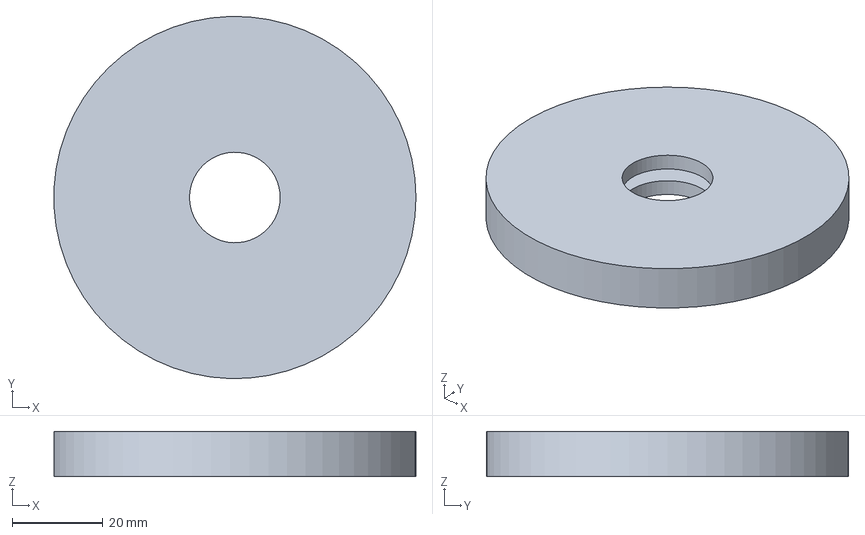
[picture p29: CAD file, 2026-04-13]
CAD/FreeCAD/07_Exports/STEP/CuttingHead/Cutting_Wheel.stp
79.9 x 80.0 x 10.0 mm
