oktaycit/CNCRevizyon/CAD/FreeCAD/07_Exports/STEP/Electronics/R1-EC_Housing.stp

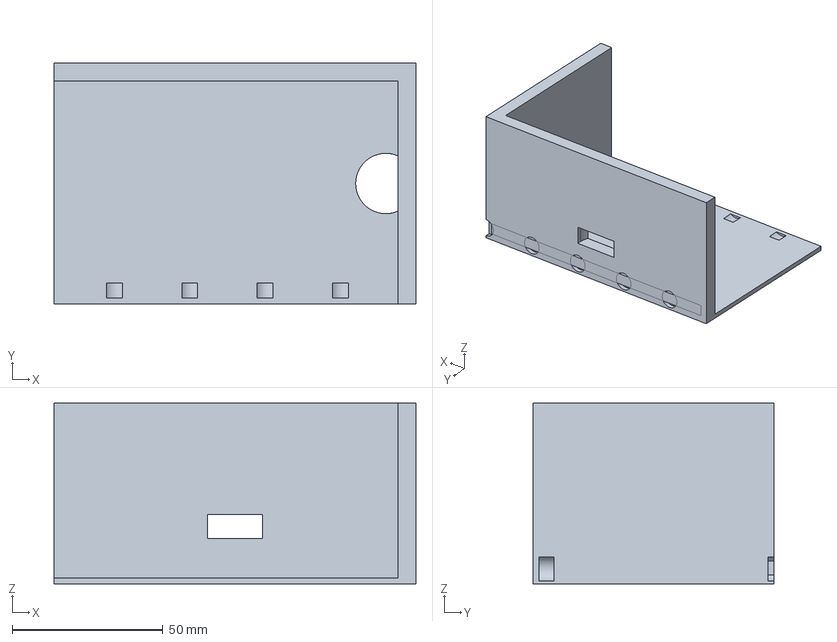
[picture p30: CAD file, 2026-04-13]
CAD/FreeCAD/07_Exports/STEP/Electronics/R1-EC_Housing.stp
120.0 x 80.0 x 60.0 mm
