oktaycit/CNCRevizyon/CAD/FreeCAD/07_Exports/STEP/Frame/PortalFrame.stp

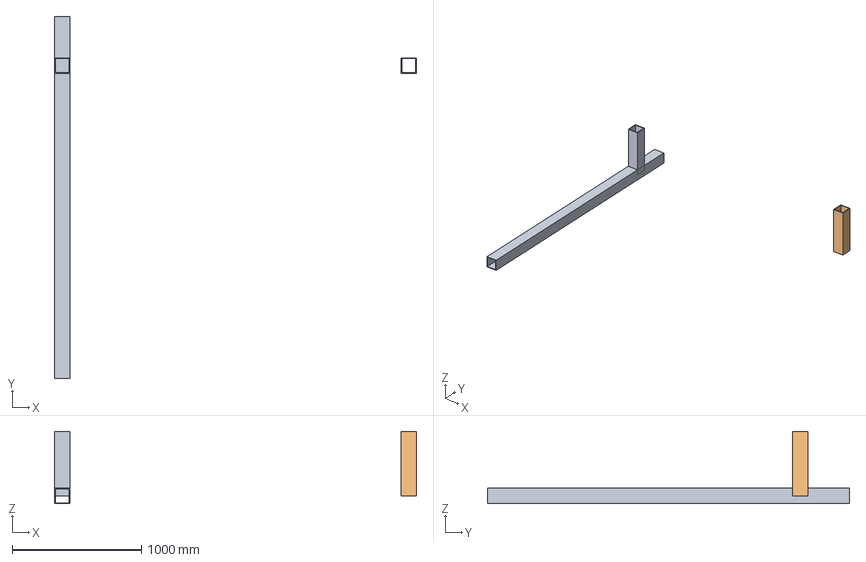
[picture p31: CAD file, 2026-04-13]
CAD/FreeCAD/07_Exports/STEP/Frame/PortalFrame.stp
2800.0 x 2800.0 x 560.0 mm
