oktaycit/CNCRevizyon/CAD/FreeCAD/07_Exports/STEP/LinearGuides/HIWIN_HGH25_Y_Rail.stp

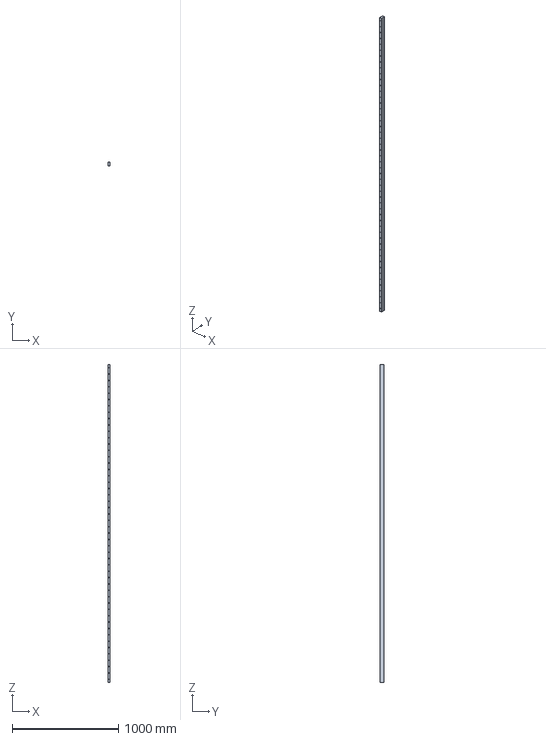
[picture p32: CAD file, 2026-04-13]
CAD/FreeCAD/07_Exports/STEP/LinearGuides/HIWIN_HGH25_Y_Rail.stp
23.0 x 40.0 x 3000.0 mm
