oktaycit/CNCRevizyon/CAD/FreeCAD/07_Exports/STEP/Motors/ECMA-E11320.stp

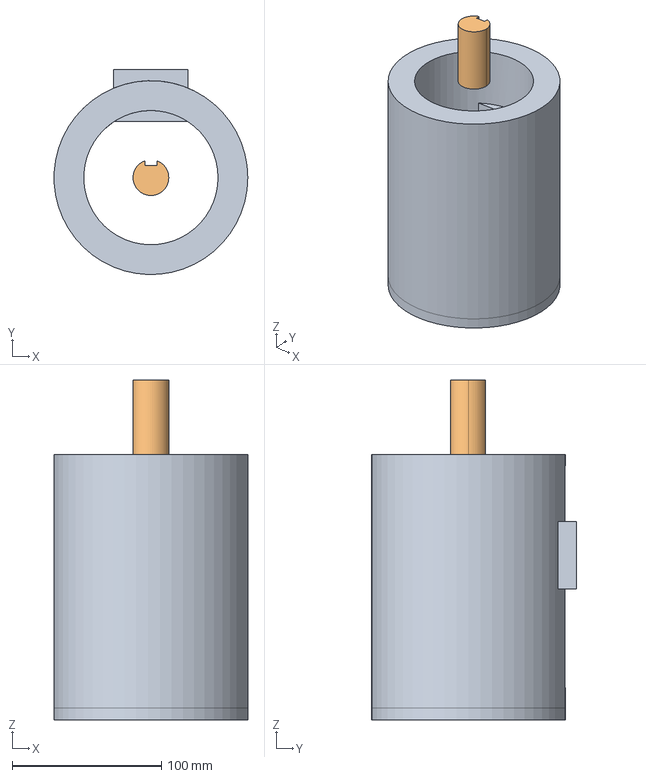
[picture p33: CAD file, 2026-04-13]
CAD/FreeCAD/07_Exports/STEP/Motors/ECMA-E11320.stp
129.9 x 137.5 x 228.0 mm
