oktaycit/CNCRevizyon/Delivery/Panocu_FreeCAD_2026-04-12/Operator_Panel/DOP-110CS_Panel_Cutout.stp

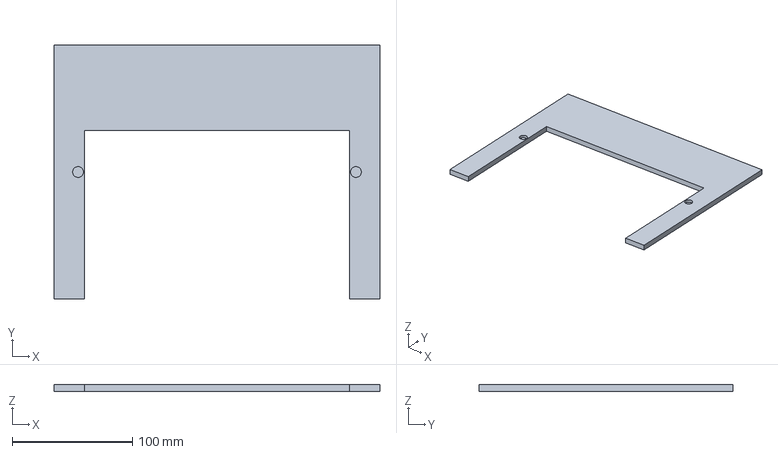
[picture p34: CAD file, 2026-04-07]
Delivery/Panocu_FreeCAD_2026-04-12/Operator_Panel/DOP-110CS_Panel_Cutout.stp
271.0 x 211.0 x 6.00 mm
