oktaycit/CNCRevizyon/CAD/FreeCAD/07_Exports/STEP/CuttingHead/ZAxis_Housing.stp

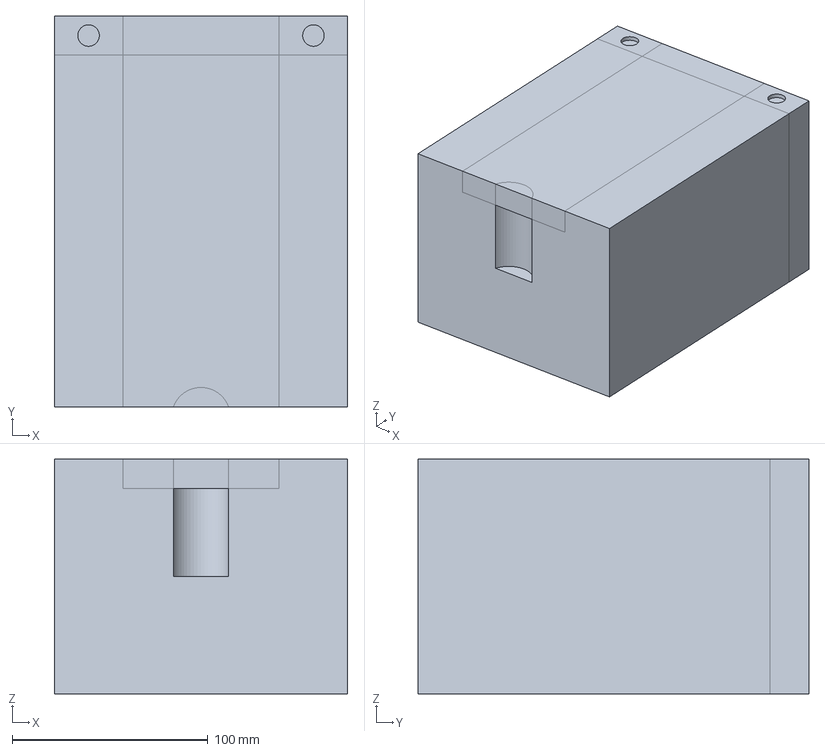
[picture p35: CAD file, 2026-04-13]
CAD/FreeCAD/07_Exports/STEP/CuttingHead/ZAxis_Housing.stp
150.0 x 200.0 x 120.0 mm
