oktaycit/CNCRevizyon/CAD/FreeCAD/07_Exports/STEP/LinearGuides/HIWIN_HGH25_X_Rail.stp

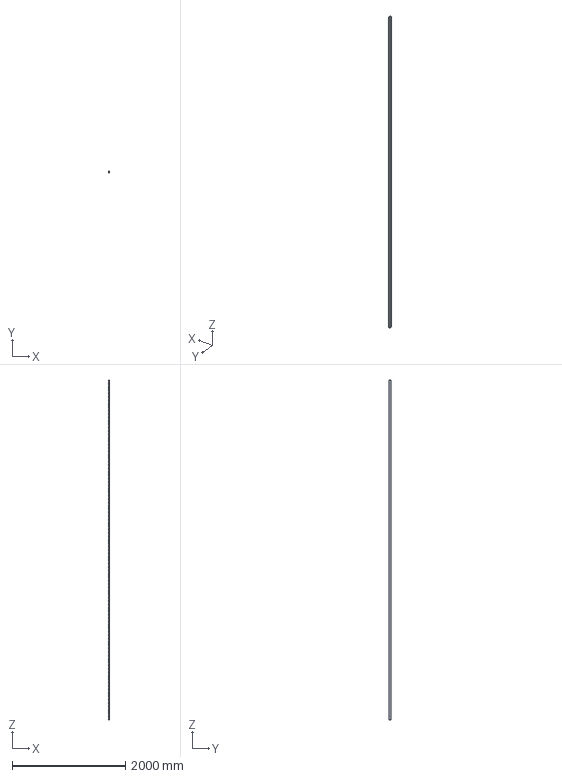
[picture p36: CAD file, 2026-04-13]
CAD/FreeCAD/07_Exports/STEP/LinearGuides/HIWIN_HGH25_X_Rail.stp
23.0 x 40.0 x 6000.0 mm
