oktaycit/CNCRevizyon/CAD/FreeCAD/07_Exports/STEP/Motors/ECMA-E11315.stp

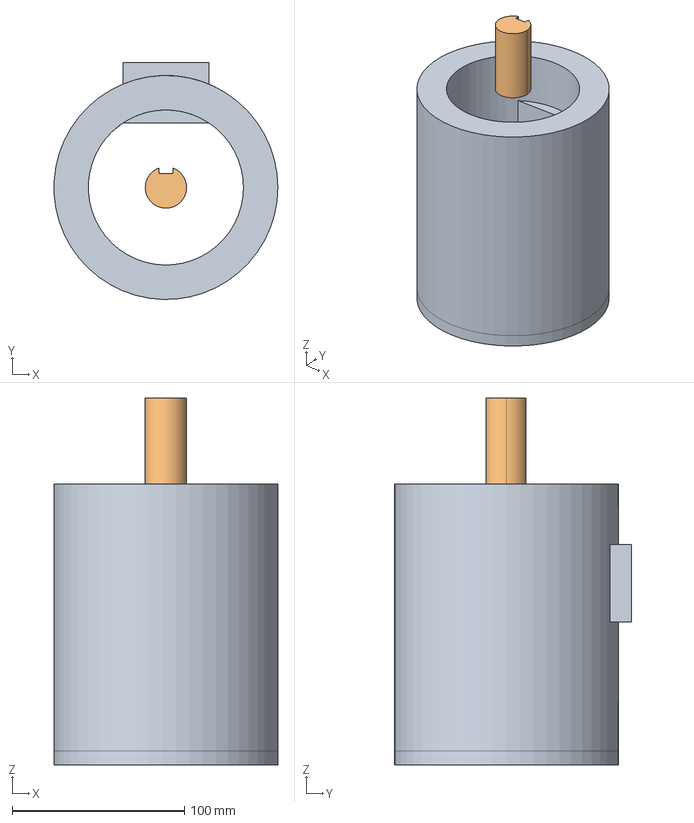
[picture p37: CAD file, 2026-04-13]
CAD/FreeCAD/07_Exports/STEP/Motors/ECMA-E11315.stp
129.9 x 137.5 x 213.0 mm
