oktaycit/CNCRevizyon/Delivery/Panocu_FreeCAD_2026-04-12/Operator_Panel/IP65_Vent_Filter.stp

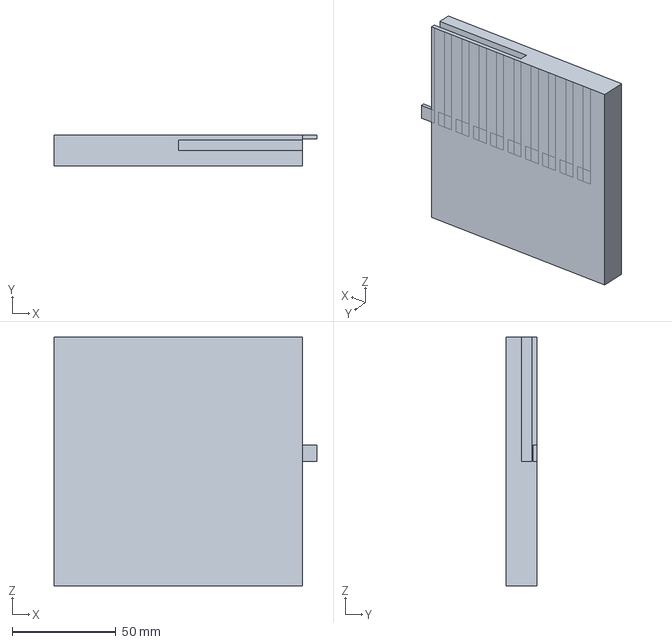
[picture p38: CAD file, 2026-04-07]
Delivery/Panocu_FreeCAD_2026-04-12/Operator_Panel/IP65_Vent_Filter.stp
127.0 x 15.0 x 120.0 mm
