oktaycit/CNCRevizyon/CAD/FreeCAD/07_Exports/STEP/CuttingHead/Motor_Coupling.stp

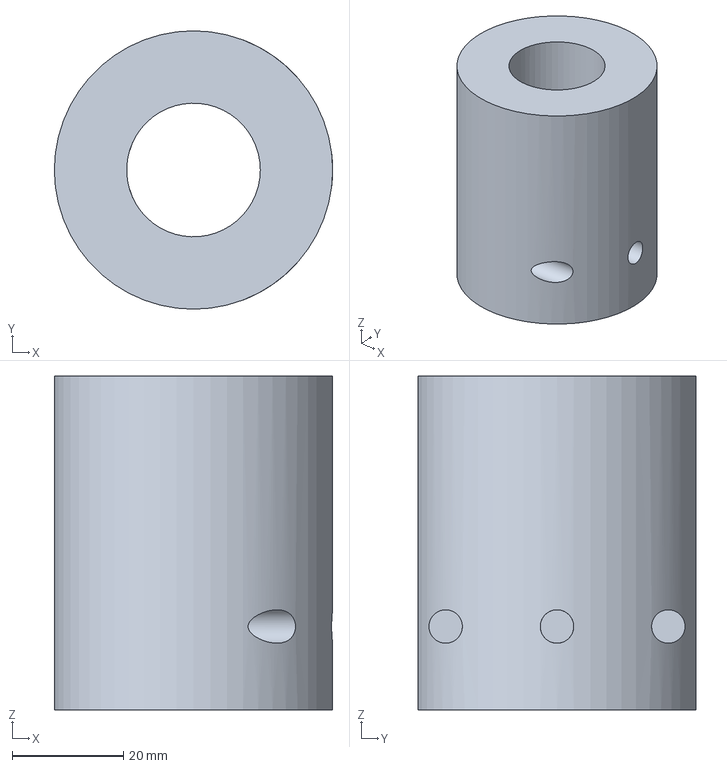
[picture p39: CAD file, 2026-04-13]
CAD/FreeCAD/07_Exports/STEP/CuttingHead/Motor_Coupling.stp
50.0 x 50.0 x 60.0 mm
