oktaycit/CNCRevizyon/Delivery/Panocu_FreeCAD_2026-04-12/Operator_Panel/Operator_Terminal_Enclosure.stp

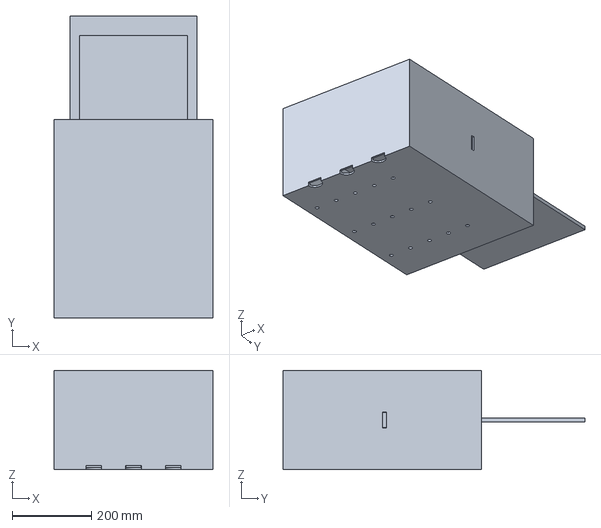
[picture p40: CAD file, 2026-04-07]
Delivery/Panocu_FreeCAD_2026-04-12/Operator_Panel/Operator_Terminal_Enclosure.stp
400.0 x 760.0 x 250.0 mm
