oktaycit/CNCRevizyon/Delivery/Panocu_FreeCAD_2026-04-12/Operator_Panel/Operator_Terminal_Door.stp

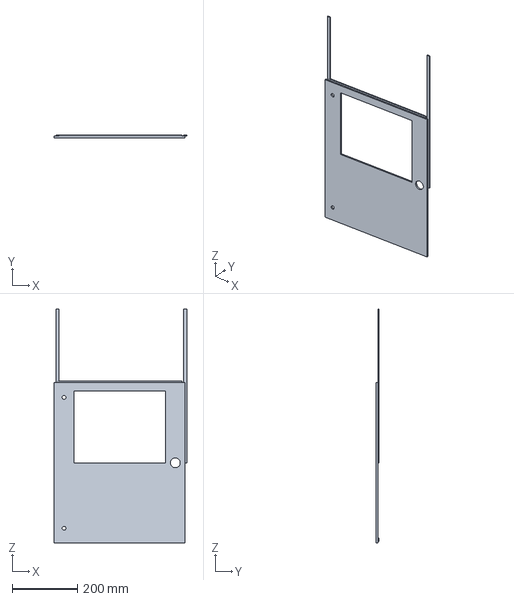
[picture p41: CAD file, 2026-04-07]
Delivery/Panocu_FreeCAD_2026-04-12/Operator_Panel/Operator_Terminal_Door.stp
405.0 x 8.00 x 715.0 mm
