oktaycit/CNCRevizyon/CAD/FreeCAD/07_Exports/STEP/CuttingHead/Wheel_Mount.stp

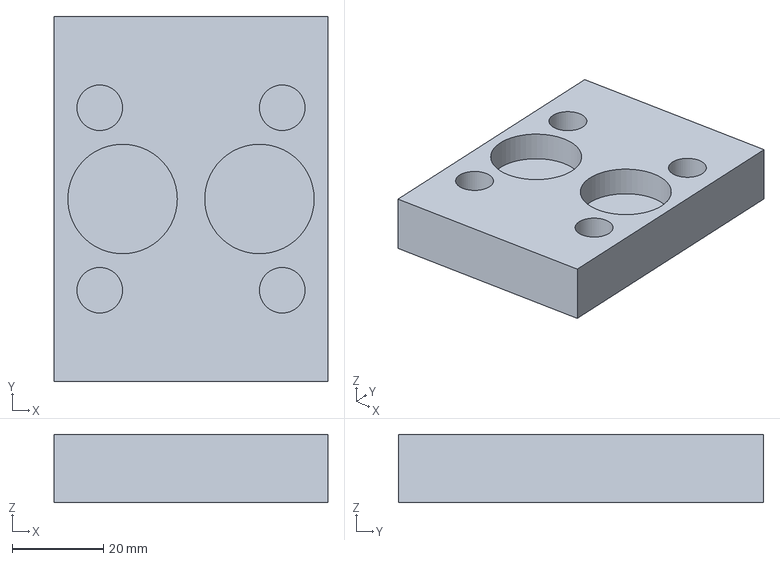
[picture p42: CAD file, 2026-04-13]
CAD/FreeCAD/07_Exports/STEP/CuttingHead/Wheel_Mount.stp
60.0 x 80.0 x 15.0 mm
