oktaycit/CNCRevizyon/CAD/FreeCAD/07_Exports/STEP/Electronics/Encoder_Bracket.stp

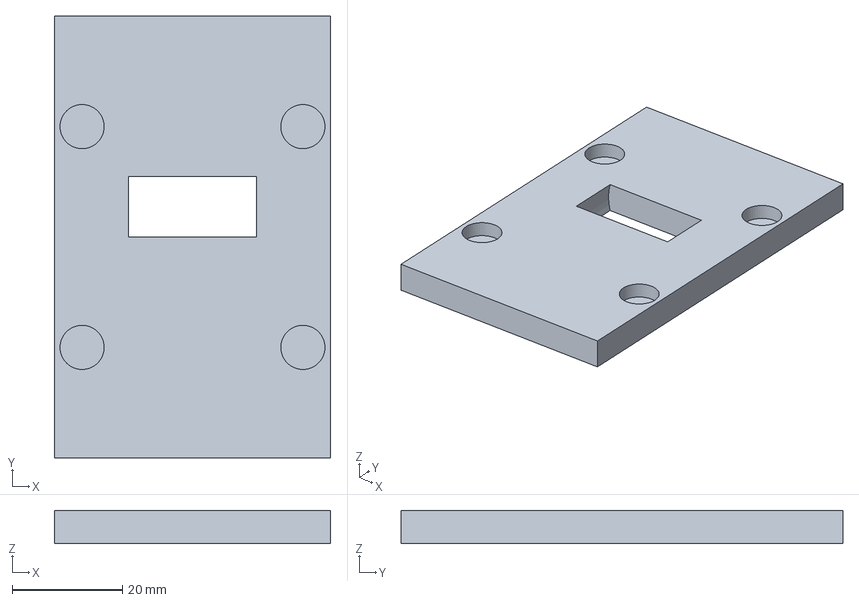
[picture p43: CAD file, 2026-04-13]
CAD/FreeCAD/07_Exports/STEP/Electronics/Encoder_Bracket.stp
50.0 x 80.0 x 6.00 mm
