oktaycit/CNCRevizyon/CAD/FreeCAD/07_Exports/STEP/Electronics/Cable_Carrier.stp

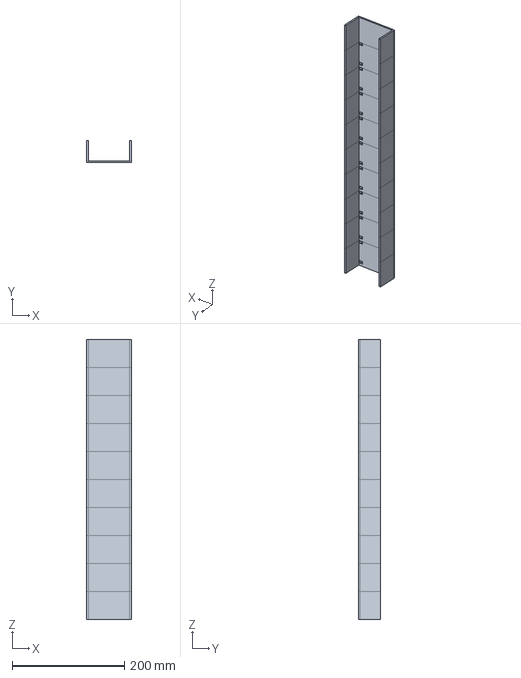
[picture p44: CAD file, 2026-04-13]
CAD/FreeCAD/07_Exports/STEP/Electronics/Cable_Carrier.stp
80.0 x 40.0 x 500.0 mm
