oktaycit/CNCRevizyon/CAD/FreeCAD/07_Exports/STEP/Electronics/Operator_Terminal_Enclosure.stp

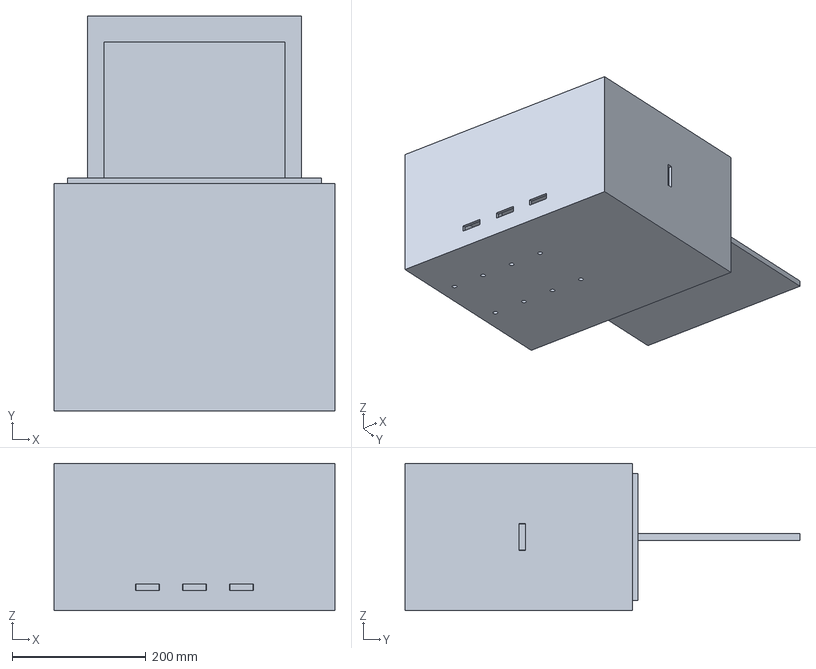
[picture p45: CAD file, 2026-04-13]
CAD/FreeCAD/07_Exports/STEP/Electronics/Operator_Terminal_Enclosure.stp
420.0 x 590.0 x 220.0 mm
