oktaycit/CNCRevizyon/CAD/FreeCAD/07_Exports/STEP/Electronics/Operator_Terminal_Door.stp

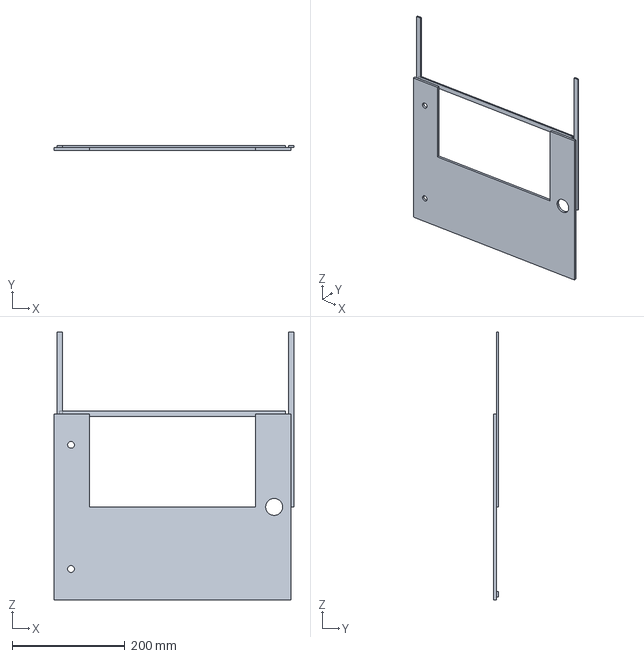
[picture p46: CAD file, 2026-04-13]
CAD/FreeCAD/07_Exports/STEP/Electronics/Operator_Terminal_Door.stp
425.0 x 8.00 x 475.0 mm
