oktaycit/CNCRevizyon/CAD/FreeCAD/07_Exports/STEP/Electronics/R1-EC_Lid.stp

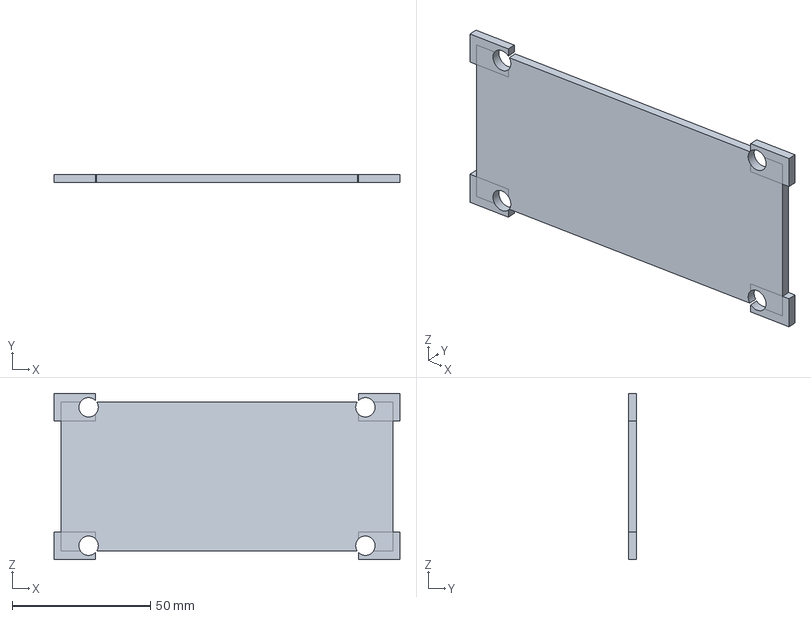
[picture p47: CAD file, 2026-04-13]
CAD/FreeCAD/07_Exports/STEP/Electronics/R1-EC_Lid.stp
125.0 x 3.00 x 60.0 mm
