oktaycit/CNCRevizyon/CAD/FreeCAD/07_Exports/STEP/Electronics/Junction_Box.stp

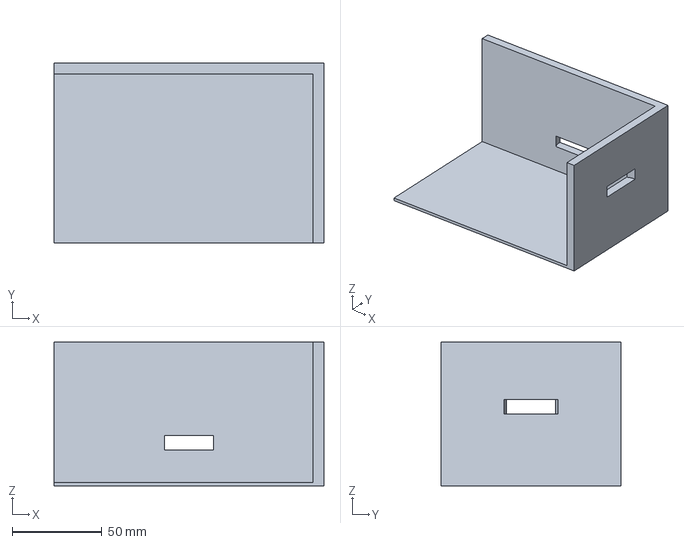
[picture p48: CAD file, 2026-04-13]
CAD/FreeCAD/07_Exports/STEP/Electronics/Junction_Box.stp
150.0 x 100.0 x 80.0 mm
