oktaycit/CNCRevizyon/(list of files, cad)

Other CAD files:
CAD/FreeCAD/07_Exports/STEP/Frame/Frame_Assembly.stp
CAD/FreeCAD/07_Exports/STEP/Electronics/Main_Panel_Body.stp
CAD/FreeCAD/07_Exports/STEP/Electronics/Main_Panel_Mounting_Plate.stp
Delivery/SolidWorks_Import_2026-04-12/Operator_Panel/Cable_Gland_M40.stp
Delivery/Panocu_FreeCAD_2026-04-12/Operator_Panel/Cable_Gland_M40.stp
CAD/FreeCAD/07_Exports/STEP/Assembly/GFB_60_30RE_S_Hybrid_Line.stp
CAD/FreeCAD/07_Exports/STEP/Frame/CornerBracket.stp
CAD/FreeCAD/07_Exports/STEP/Electronics/Cable_Gland_M40.stp
CAD/FreeCAD/07_Exports/STEP/Frame/SupportLeg.stp
CAD/FreeCAD/07_Exports/STEP/Electronics/R1-EC_Mounting_Plate.stp
CAD/FreeCAD/07_Exports/STEP/Electronics/IP65_Vent_Filter.stp
CAD/FreeCAD/07_Exports/STEP/Electronics/DOP-110CS_Housing.stp
CAD/FreeCAD/07_Exports/STEP/Electronics/DOP-110CS_Panel_Cutout.stp
CAD/30RE-S Hibrit Sistem.3mf
CAD/FreeCAD/07_Exports/STEP/CuttingHead/Glass_Edge_Deletion_Head.FCStd
CAD/FreeCAD/07_Exports/STEP/Electronics/Main_Panel_Body.FCStd
CAD/FreeCAD/07_Exports/STEP/Electronics/Main_Panel_Door.FCStd
CAD/FreeCAD/07_Exports/STEP/Electronics/Main_Panel_Mounting_Plate.FCStd
Delivery/Panocu_FreeCAD_2026-04-12/07_Exports/STEP/Electronics/Main_Panel_Body.FCStd
Delivery/Panocu_FreeCAD_2026-04-12/07_Exports/STEP/Electronics/Main_Panel_Door.FCStd
Delivery/Panocu_FreeCAD_2026-04-12/07_Exports/STEP/Electronics/Main_Panel_Mounting_Plate.FCStd
