oktaycit/CNCRevizyon/Electrical/Panel_Manufacturer/REVIZYON_1_RAPORU.md

# GFB60-30RE-S Revizyon_1 Raporu

**Tarih:** 12.04.2026  
**Kapsam:** `Electrical/Panel_Manufacturer` teslim paketinin tam dosya analizi ve HMI uzak montaj degisikliklerinin ozet raporu

---

## 1. Analiz Ozeti

Bu incelemede `Electrical/Panel_Manufacturer` altindaki metin dosyalari, wiring listeleri, BOM ve sema kaynaklari tekrar taranmistir.

Ana degisiklik konusu:

- `U2 / DOP-110CS` operator terminalinin ana pano uzerinden cikarilip
- koprunun home noktalarina yakin
- saha montajli uzak operator terminali olarak tanimlanmasidir.

---

## 2. Guncellenen Belgeler

Asagidaki dosyalarda HMI uzak montaj senaryosu metinsel olarak islenmistir:

| Dosya | Durum | Ozet |
|---|---|---|
| `README.md` | Guncellendi | Paket ana notuna uzak HMI bilgisi eklendi |
| `00_TITLE_PAGE.md` | Guncellendi | Revizyon `4.2`, tarih `12.04.2026`, uzak HMI notu eklendi |
| `01_PANEL_LAYOUT.md` | Guncellendi | HMI'nin pano disinda oldugu notu ve saha montajli `U2` satiri eklendi |
| `02_TERMINAL_DIAGRAMS.md` | Guncellendi | X2 HMI besleme cikisi saha cikisi olarak duzenlendi |
| `03_CABLE_SCHEDULE.md` | Guncellendi | Uzak HMI saha kablolari yeni bolum olarak eklendi |
| `04_ASSEMBLY_NOTES.md` | Guncellendi | Ana pano/kapak montaj yasağı ve saha montaj tarifi eklendi |
| `BOM/GFB60-30RE-S_BOM.md` | Guncellendi | `U2` icin `uzak saha montaj` notu eklendi |
| `Wiring/TERMINAL_TO_TERMINAL_LIST.md` | Guncellendi | HMI 24V, 0V ve Ethernet baglantilari uzak HMI olarak netlestirildi |
| `Wiring/WIRE_LIST_SAHA.md` | Guncellendi | Uzak HMI besleme ve Ethernet saha listesine eklendi |

---

## 3. Teknik Degisiklikler

Revizyon_1 kapsaminda belgelerde su teknik etkiler olusturulmustur:

1. Ana pano kapaginda HMI kesiti acilmamasi gerektigi netlestirildi.
2. HMI icin pano icinden sadece cikis noktasi tanimlandi:
   - `X2.3` -> +24V HMI saha cikisi
   - `X2.4` -> 0V HMI saha cikisi
3. Uzak HMI saha kablolari ayri tanimlandi:
   - `W008A` -> `X2.3` den `U2 +V`
   - `W009` -> `X2.4` den `U2 -V`
   - `W014` -> PE bara den `U2 FG`
   - `W308` -> `U1 NC300 CN3` den `U2 ETH`
4. HMI konumu operatorun home/referans islemini rahat takip edecegi saha noktasi olarak belirtildi.

---

## 4. Tespit Edilen Tutarsizliklar

Paket genelinde degisiklikler buyuk olcude islenmis olsa da asagidaki dosyalarda revizyon/tanim tutarsizliklari halen mevcuttur:

### 4.1 Revizyon numarasi tutarsizliklari

- `00_TITLE_PAGE.md` ust ASCII kapakta halen `Revizyon 4.1 FINAL` yaziyor.
- `02_TERMINAL_DIAGRAMS.md` ust bilgide halen `Revizyon: 4.1` gorunuyor.
- `01_PANEL_LAYOUT.md` icindeki revizyon gecmisi tablosunda `4.2` satiri henuz ekli degil.
- `BOM/GFB60-30RE-S_BOM.md` sonunda `Versiyon: 1.1 (Revizyon 4.1 yayini)` ifadesi bulunuyor.

### 4.2 Sema kaynaklari revizyonu

DrawIO kaynaklarinda ana isimlendirme ve sayfa basliklari halen `Rev4.1` veya `Revizyon 4.1` olarak geciyor:

- `Schematics/GFB60_30RE_S_Electrical_Rev4.1*.drawio`
- `Schematics/GFB60_30RE_S_Electrical.drawio`
- `Schematics/GFB60_30RE_S_Wiring_Diagram.drawio`

Bu durum teslim edilen metin paketi ile sema kaynaklari arasinda revizyon farki olusturmaktadir.

### 4.3 HMI tanimi sema tarafinda genel kalmis

Sema dosyalarinda HMI elektriksel olarak dogru gorunse de `uzak saha montaj` ibaresi cizim uzerinde acik sekilde ekli degildir. Ozellikle:

- `GFB60_30RE_S_Electrical.drawio`
- `GFB60_30RE_S_Wiring_Diagram.drawio`
- `GFB60_30RE_S_Electrical_Rev4.1_Page03.drawio`
- `GFB60_30RE_S_Electrical_Rev4.1_Page08.drawio`

dosyalarinda HMI baglantisi var; ancak saha montaj lokasyonu cizim notu olarak belirginlestirilmemistir.

### 4.4 Paket temizligi

- Klasorde `.DS_Store` dosyasi bulunmaktadir.
- Zip olustururken bu dosyanin dahil edilmemesi tavsiye edilir.

---

## 5. Sonuc

`Revizyon_1` kapsaminda operator terminalinin ana pano disinda, kopru home noktalarina yakin saha montajli oldugu belgelerde buyuk oranda netlestirilmistir.

Ancak paketin tam anlamiyla tek revizyonlu ve teslime hazir hale gelmesi icin bir sonraki adimda su isler onerilir:

1. Tum ust bilgi bloklarini ve revizyon tablolarini `4.2` ile hizalamak
2. DrawIO sema baslik ve notlarini `uzak HMI` senaryosuna gore guncellemek
3. Zip teslimini `.DS_Store` haric olacak sekilde temiz paketlemek

---

## 6. Analiz Edilen Dosyalar

Toplam taranan baslica dosyalar:

- `00_TITLE_PAGE.md`
- `01_PANEL_LAYOUT.md`
- `02_TERMINAL_DIAGRAMS.md`
- `03_CABLE_SCHEDULE.md`
- `04_ASSEMBLY_NOTES.md`
- `README.md`
- `BOM/GFB60-30RE-S_BOM.md`
- `Wiring/TERMINAL_TO_TERMINAL_LIST.md`
- `Wiring/WIRE_LIST_SAHA.md`
- `Schematics/` altindaki tum `.drawio` ve `.pdf` kaynaklari
