oktaycit/CNCRevizyon/Electrical/Electrical/Panel_Manufacturer/00_TITLE_PAGE.md

# GFB60-30RE-S Elektrik Semasi Paketi

# Pano Imalatina Teslim Belgeleri

---

```
+============================================================================+
|                                                                            |
|                       GFB60-30RE-S                                          |
|                   ELEKTRIK SEMASI PAKETI                                    |
|                                                                            |
|                    Revizyon 4.1 FINAL                                       |
|                                                                            |
|                                                                            |
|                    LiSEC GFB-60/30RE                                        |
|                 Cam Kesme Makinesi Revizyonu                                |
|                                                                            |
|                     CNCRevizyon Projesi                                     |
|                                                                            |
+============================================================================+
```

---

## PROJE BILGILERI

| Parametre | Deger |
|---|---|
| **Makine Model** | LiSEC GFB-60/30RE |
| **Makine Tip** | Cam Kesme CNC |
| **Revizyon No** | 4.2 |
| **Belge Tarihi** | 12.04.2026 |
| **Belge Durumu** | FINAL - Pano Imalatina Hazir |
| **Musteri** | CNCRevizyon |

---

## MAKINE OZELLIKLERI

| Ozellik | Deger |
|---|---|
| Maksimum Cam Boyutu | 6000 x 3000 mm |
| Minimum Cam Boyutu | 300 x 200 mm |
| Cam Kalinligi | 2-25 mm |
| Kesim Hizi | 0-80 m/dk |
| Konumlama Hassasiyet | +/- 0.05 mm |
| Eksen Sayisi | 5 (X, Y, Z, Alt, CNC/Rodaj) |
| EtherCAT Cycle Time | 1 ms |

---

## EKSEN BILGILERI

| Eksen | Servo Surucu | Motor | Power |
|---|---|---|---|
| X | ASD-A3-4523-E | ECMA-L11845 | 4.5 kW |
| Y | ASD-A3-2023-E | ECMA-E11320 | 2.0 kW |
| ALT | ASD-A3-2023-E | ECMA-E11320 | 2.0 kW |
| Z | ASD-A3-1023-E | ECMA-C11010FS | 1.0 kW (frenli) |
| CNC | ASD-A3-1523-E | ECMA-E11315 | 1.5 kW |

---

## KONTROL SISTEMI

| Bilesen | Model | Uretici |
|---|---|---|
| CNC Kontrolor | NC300-E | Delta Electronics |
| HMI | DOP-110CS 10.1" | Delta Electronics |
| EtherCAT Master | NC300 Dahili | Delta Electronics |
| Remote I/O | R1-EC Serisi | Delta Electronics |
| Safety Relay | PNOZ X2.8P | Pilz |

**Not:** `U2 / DOP-110CS` operator terminali ana pano kapagina monte edilmeyecektir. Terminal, koprunun home noktalarina yakin sahada uzak operatör istasyonu olarak konumlanacaktir.

---

## BELGE ICINDEKI

| Sayfa No | Belge | Aciklama |
|---|---|---|
| 00 | Title Page | Kapak sayfasi |
| 01 | Panel Layout | Pano yerlesim plani |
| 02 | Terminal Diagrams | Klemens ve terminal strip semalari |
| 03 | Cable Schedule | Kablo listesi ve uzunluklari |
| 04 | Assembly Notes | Montaj talimatlari |
| 05 | BOM | Malzeme listesi |
| App-A | Schematic Pages | Elektrik semasi sayfaları (DrawIO) |
| App-B | Wire List | Terminal-terminal baglanti listesi |

---

## GUVENLIK UYARILARI

```
+------------------------------------------------------------------+
|                          WARNING                                  |
|                                                                  |
|   YUKSEK GERILIM: AC 400V 3-FAZ                                  |
|   Calismadan once gucu kesin ve bogulmayi saglayin               |
|                                                                  |
|   STO (Safe Torque Off): Safety devresi kritik                   |
|   Safety kablolari SARI renk ile isaretlenmistir                 |
|                                                                  |
|   EtherCAT: 1ms cycle time                                       |
|   Network kablolarina dokunmayin calisma sirasinda               |
+------------------------------------------------------------------+
```

---

## ONAY IMZALARI

| Rol | Isim | Imza | Tarih |
|-----|---|---|---|
| Tasarimci | CNCRevizyon | _________________ | __________ |
| Teknik Kontrol | _________________ | _________________ | __________ |
| Musteri Onay | _________________ | _________________ | __________ |
| Pano Imalatci | _________________ | _________________ | __________ |

---

## CONTACT INFORMATION

**Tasarimci:**
CNCRevizyon Projesi
E-posta: proje@cncrevizyon.local

**Uretici Bilgisi (Doldurulacak):**
Pano Imalatci: _________________
Adres: _________________
Telefon: _________________

---

## REVIZYON GECMISI

| Rev | Tarih | Aciklama | Hazirlayan |
|-----|---|---|---|
| 4.0 | 05.04.2026 | Ilk yayin - Delta servo sistem | CNCRevizyon |
| 4.1 | 11.04.2026 | Pano imalat belgeleri eklendi | CNCRevizyon |
| 4.2 | 12.04.2026 | HMI uzak saha montaji olarak guncellendi | CNCRevizyon |

---

```
+============================================================================+
|                                                                            |
|               BELGE SONU                                                    |
|                                                                            |
|   Bu belge paketi pano imalatcisi icin hazirlanmistir.                     |
|   Tum semalar ve belgeler revizyon 4.2'ye uygundur.                        |
|                                                                            |
|   Sorular icin proje tasarimci ile iletisime gecin.                        |
|                                                                            |
+============================================================================+
```
