oktaycit/CNCRevizyon/Documentation/Manuals/WhatsApp Image 2026-04-02 at 09.46.57.jpeg

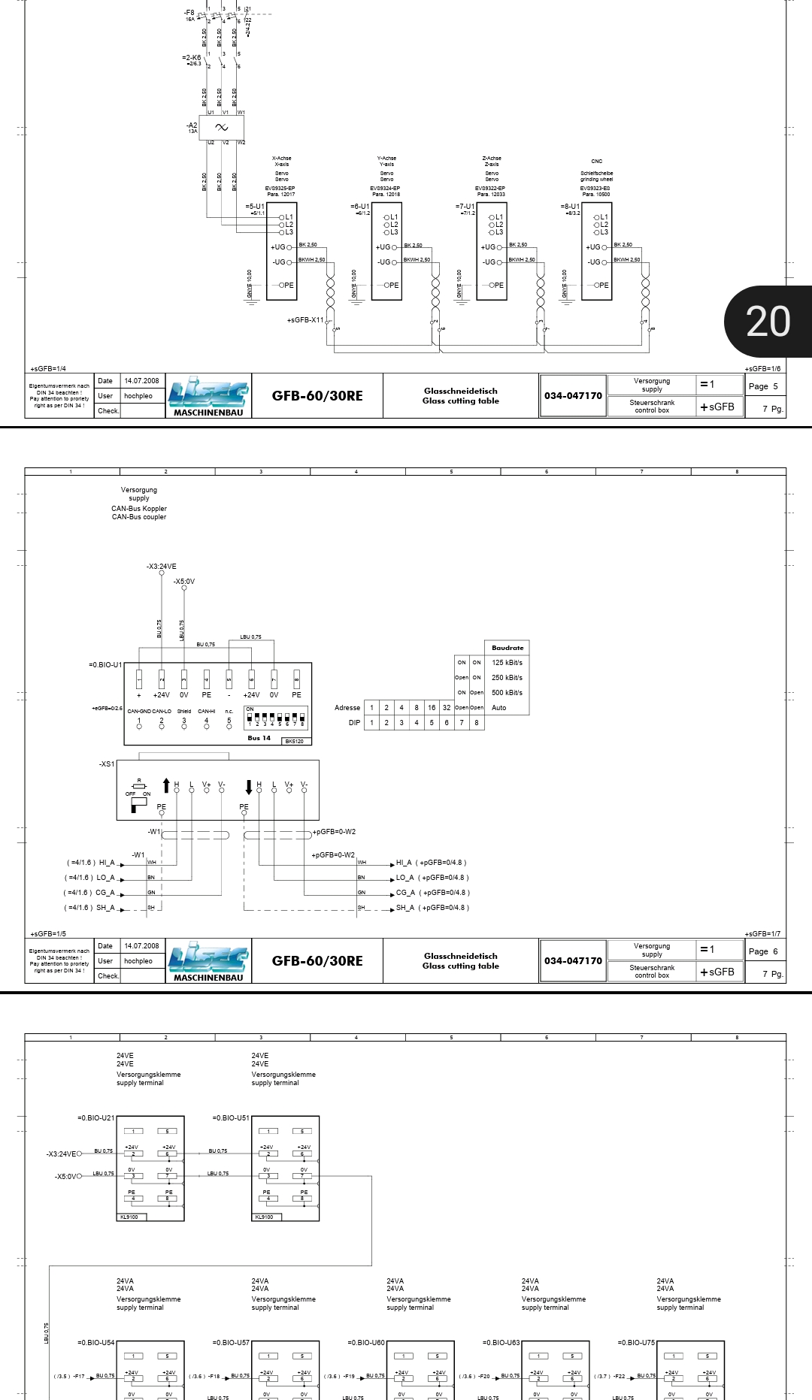
Documentation/Manuals/WhatsApp Image 2026-04-02 at 09.46.57.jpeg
