oktaycit/CNCRevizyon/GlassCutting/test.html

# 🔧 GlassCutting Test Sayfası

## ✅ Test 1: Content Script Yüklemesi

Content script durumu kontrol ediliyor...

Kontrol Et

## ✅ Test 2: G-Kod Dosya Linki Algılama

Aşağıdaki linklere sağ tıklayarak "GlassCutting ile aç" seçeneğini görebilmelisiniz:

📄 ornek_program.nc
📄 kesim.gcode
📄 test.txt

## ✅ Test 3: Drag & Drop

Bir G-kod dosyasını (.nc, .gcode, .txt) aşağıdaki alana sürükleyin:

📁 Dosyayı buraya sürükleyin

## ✅ Test 4: Klavye Kısayolu

Ctrl+Shift+G tuşlarına basarak GlassCutting eklentisini açabilirsiniz.

## ✅ Test 5: Örnek G-Kod

Aşağıdaki G-kod'u kopyalayıp GlassCutting editörüne yapıştırabilirsiniz:

; Lisec GFB-60/30RE - Test Programı
G21
G90
G0 Z50
G0 X0 Y0
G1 Z5 F500
G1 X2000 F3000
G1 Y1500
G1 X0
G1 Y0
G0 Z50
M30

Kopyala

## 📊 Test Sonuçları
