oktaycit/CNCRevizyon/Electrical/Electrical/Panel_Manufacturer/Schematics/GFB60_30RE_S_Electrical.drawio.pdf

# GFB60/30RE-S 01 Ana Guc ve 24VDC Dagitimi

Orijinal GFB dokumani ve Delta/Pilz referanslarina gore guc dagitim omurgasi

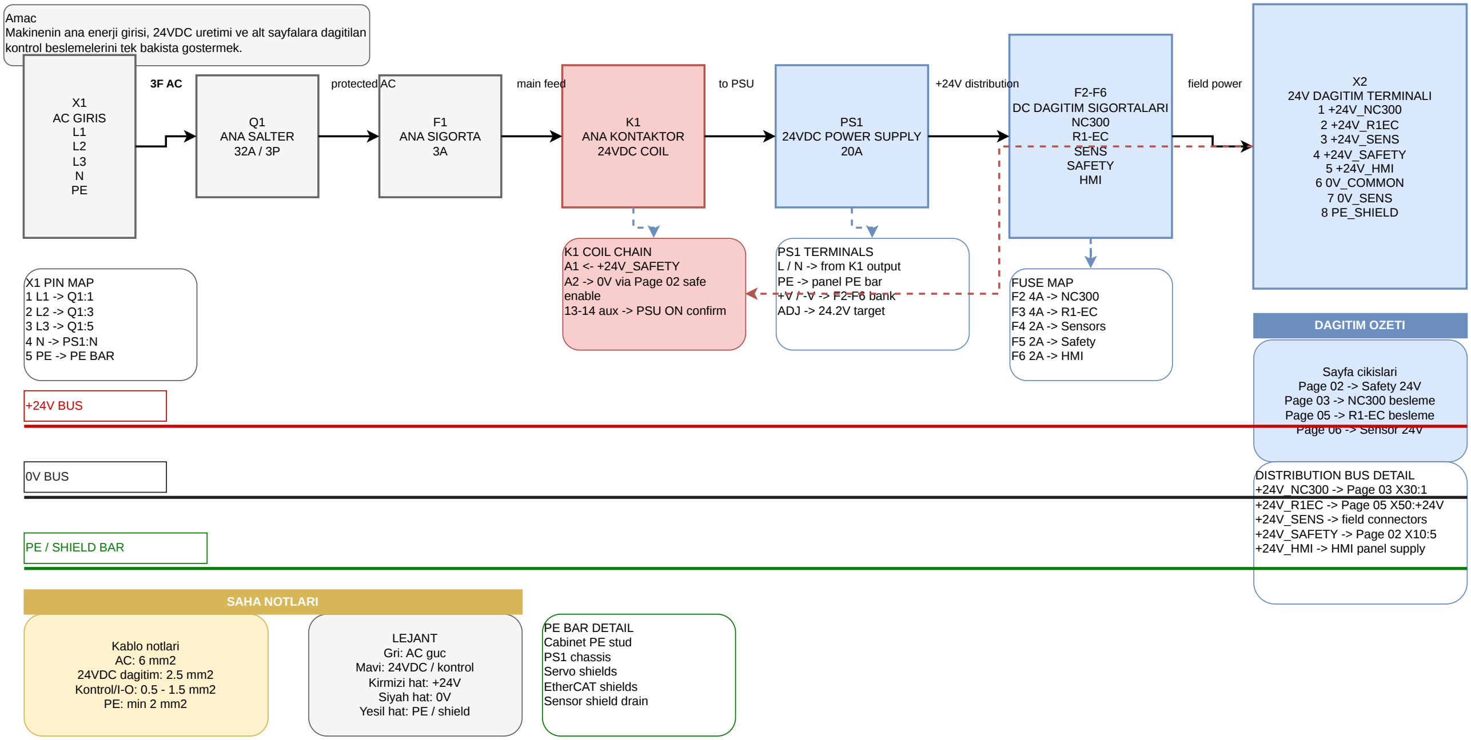
[picture p50: figure]
Amac; kontrol beslemelerini tek bakista gostermek.; X1 AC GIRIS L1 L2 L3 N PE; Q1 ANA SALTER 32A / 3P; F1 ANA SIGORTA 3A; K1 ANA KONTAKTOR 24VDC COIL; PS1 24VDC POWER SUPPLY 20A; F2-F6 DC DAGITIM SIGORTALARI NC300 R1-EC SENS SAFETY HMI; X2 24V DAGITIM TERMINALI 1 +24V_NC300 2 +24V_R1EC 3 +24V_SENS 4 +24V_SAFETY 5 +24V_HMI 6 0V_COMMON 7 0V_SENS 8 PE_SHIELD; +24V BUS; 0V BUS; PE / SHIELD BAR; LEJANT Gri: AC guc Mavi: 24VDC / kontrol Kirmizi hat: +24V Siyah hat: 0V Yesil hat: PE / shield; Kablo notlari AC: 6 mm2 24VDC dagitim: 2.5 mm2 Kontrol/I-O: 0.5 - 1.5 mm2 PE: min 2 mm2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

Makinenin ana enerji girisi, 24VDC uretimi ve alt sayfalara dagitilan

PAGE 01 / POWER

Rev A | Draw.io electrical package | Source: GFB60/30RE-S reference docs | Prepared in Codex workspace | For PDF issue / review use | Sheet 1 / 6

# 02 Emniyet Zinciri ve STO

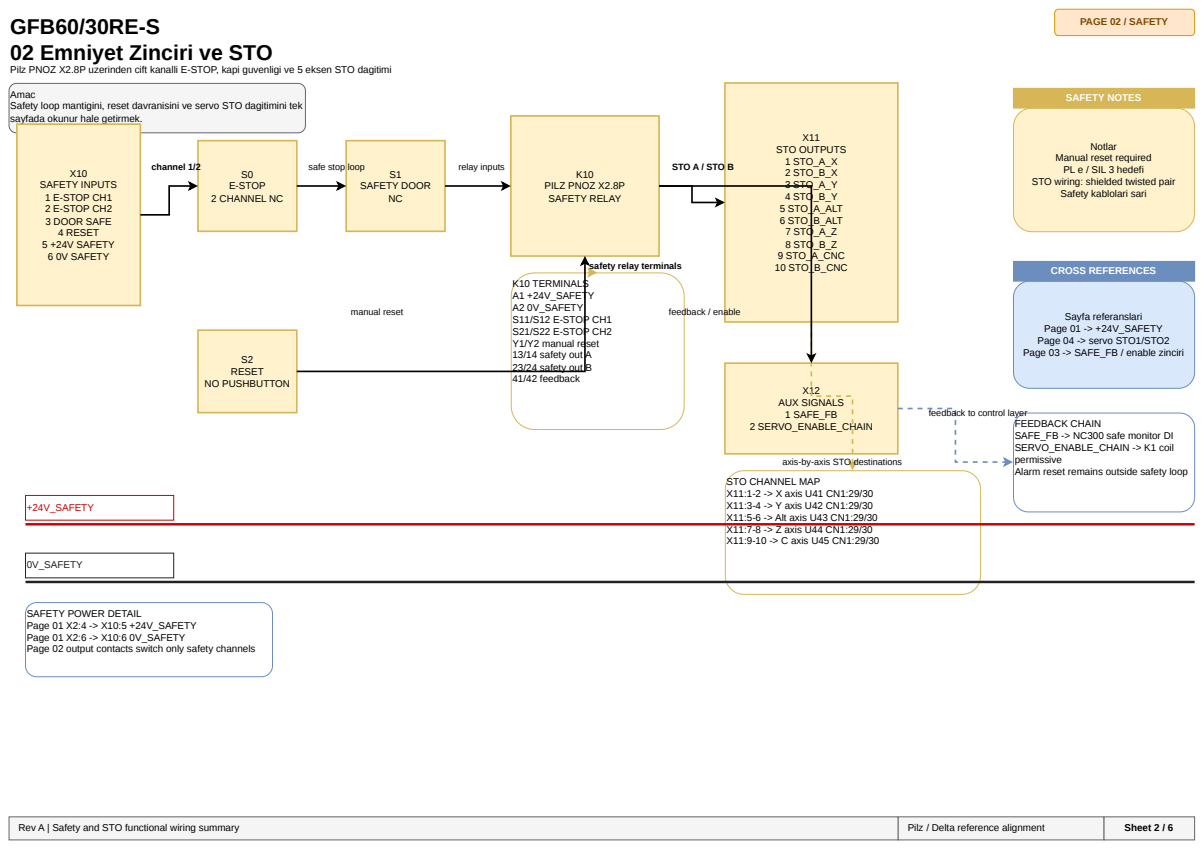
[picture p51: page 2]
PAGE 02 / SAFETY; X10 SAFETY INPUTS 1 E-STOP CH1 2 E-STOP CH2 3 DOOR SAFE 4 RESET 5 +24V SAFETY 6 0V SAFETY; S0 E-STOP 2 CHANNEL NC; S1 SAFETY DOOR NC; K10 PILZ PNOZ X2.8P SAFETY RELAY; X11 STO OUTPUTS 1 STO_A_X 2 STO_B_X 3 STO_A_Y 4 STO_B_Y 5 STO_A_ALT 6 STO_B_ALT 7 STO_A_Z 8 STO_B_Z 9 STO_A_CNC 10 STO_B_CNC; S2 RESET NO PUSHBUTTON; X12 AUX SIGNALS 1 SAFE_FB 2 SERVO_ENABLE_CHAIN; +24V_SAFETY; 0V_SAFETY; Notlar; SAFETY NOTES; CROSS REFERENCES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

Pilz PNOZ X2.8P uzerinden cift kanalli E-STOP, kapi guvenligi ve 5 eksen STO dagitimi

Amac
Safety loop mantigini, reset davranisini ve servo STO dagitimini tek
sayfada okunur hale getirmek.

Manual reset required
PL e / SIL 3 hedefi
STO wiring: shielded twisted pair
Safety kablolari sari

safety relay terminals

Sayfa referanslari
Page 01 -> +24V_SAFETY
Page 04 -> servo STO1/STO2
Page 03 -> SAFE_FB / enable zinciri

feedback to control layer

FEEDBACK CHAIN
SAFE_FB -> NC300 safe monitor DI
SERVO_ENABLE_CHAIN -> K1 coil
permissive
Alarm reset remains outside safety loop

axis-by-axis STO destinations

STO CHANNEL MAP
X11:1-2 -> X axis U41 CN1:29/30
X11:3-4 -> Y axis U42 CN1:29/30
X11:5-6 -> Alt axis U43 CN1:29/30
X11:7-8 -> Z axis U44 CN1:29/30
X11:9-10 -> C axis U45 CN1:29/30

SAFETY POWER DETAIL
Page 01 X2:4 -> X10:5 +24V_SAFETY
Page 01 X2:6 -> X10:6 0V_SAFETY
Page 02 output contacts switch only safety channels

# 03 NC300 ve EtherCAT Omurgasi

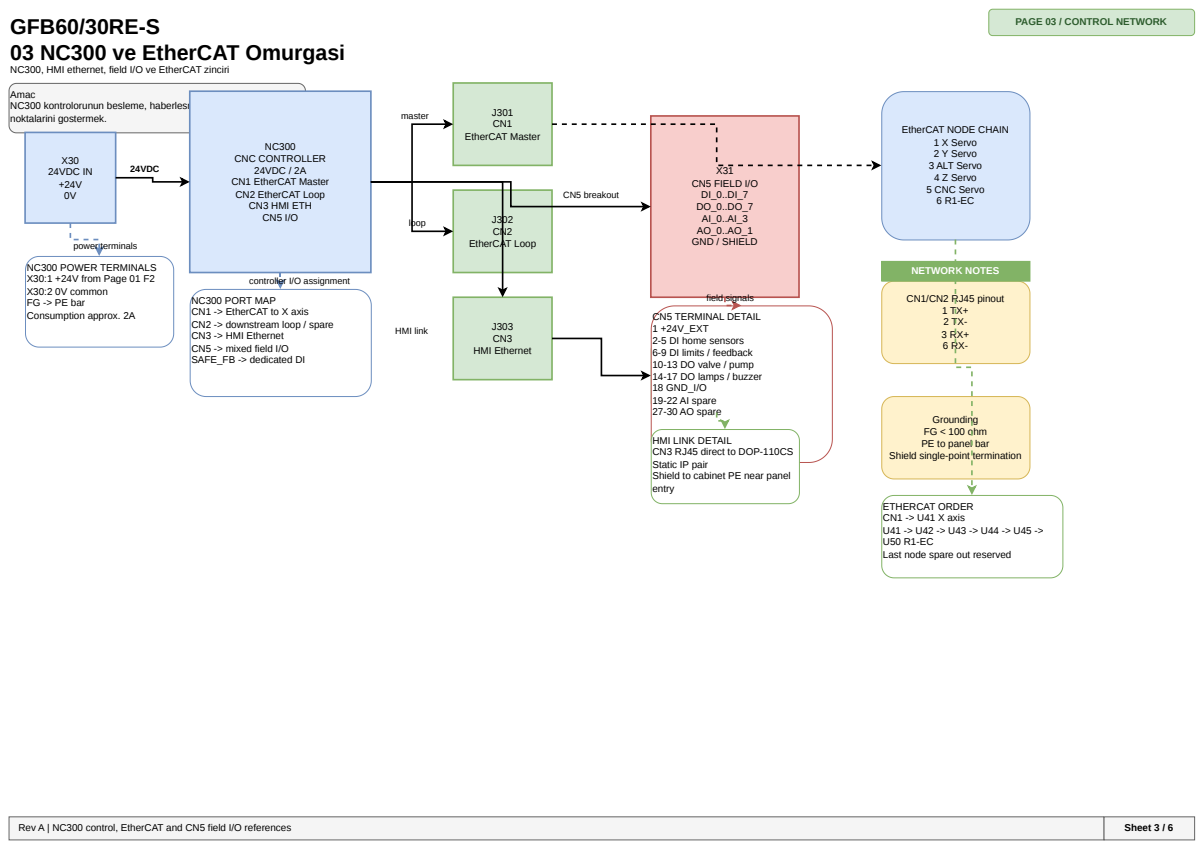
[picture p52: page 3]

NC300, HMI ethernet, field I/O ve EtherCAT zinciri

Amac
NC300 kontrolorunun besleme, haberlesme ve saha I/O kirilim
noktalarini gostermek.

Grounding
FG < 100 ohm
PE to panel bar
Shield single-point termination

HMI LINK DETAIL
CN3 RJ45 direct to DOP-110CS
Static IP pair
Shield to cabinet PE near panel
entry

# 04 Servo Suruculer

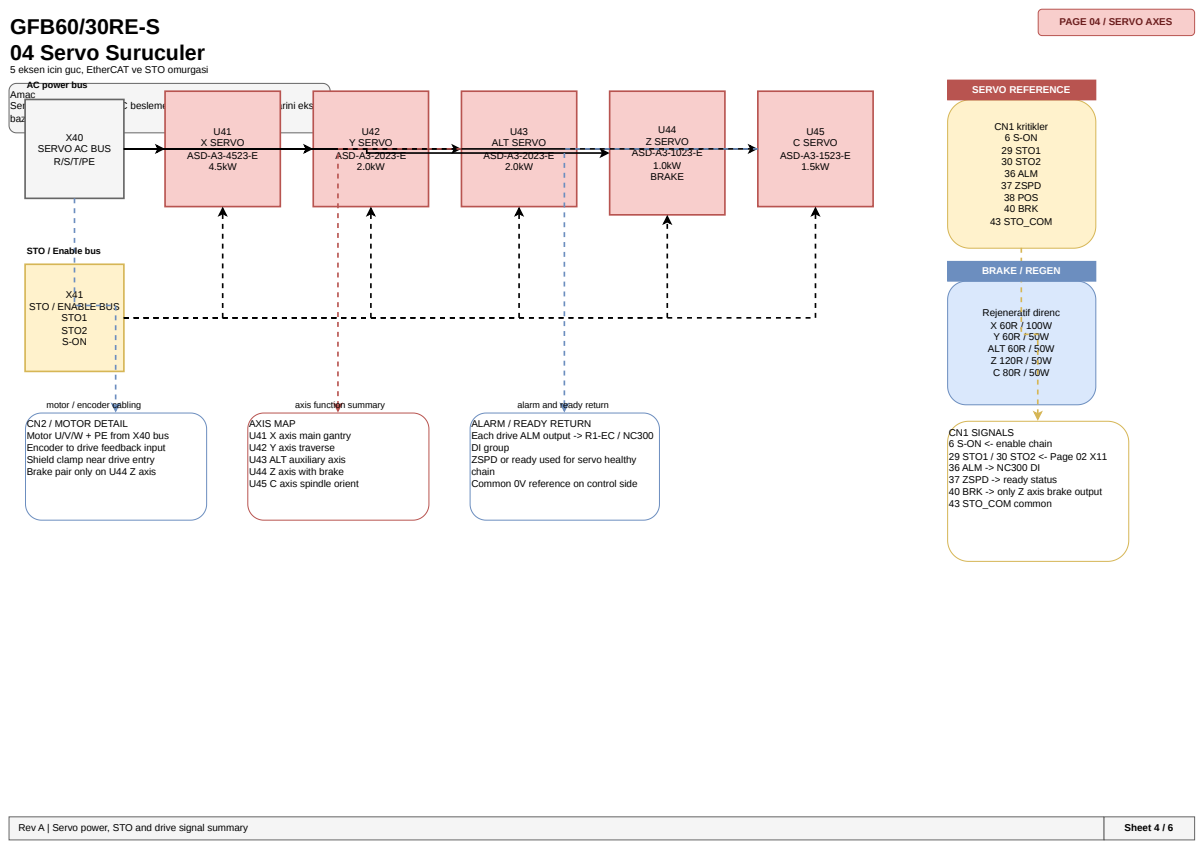
[picture p53: page 4]
X40 SERVO AC BUS R/S/T/PE; X41 STO / ENABLE BUS STO1 STO2 S-ON; U41 X SERVO ASD-A3-4523-E 4.5kW; U42 Y SERVO ASD-A3-2023-E 2.0kW; U43 ALT SERVO ASD-A3-2023-E 2.0kW; U44 Z SERVO ASD-A3-1023-E 1.0kW BRAKE; U45 C SERVO ASD-A3-1523-E 1.5kW; CN1 kritikler 6 S-ON 29 STO1 30 STO2 36 ALM 37 ZSPD 38 POS 40 BRK 43 STO_COM; Rejeneratif direnc X 60R / 100W Y 60R / 50W ALT 60R / 50W Z 120R / 50W C 80R / 50W; motor / encoder cabling; axis function summary; alarm and ready return; SERVO REFERENCE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

PAGE 04 / SERVO AXES

5 eksen icin guc, EtherCAT ve STO omurgasi
AC power bus
Amac
Servo suruculerin ortak AC besleme ve STO/Enable baglantilarini eksen
bazinda gostermek.

STO / Enable bus

CN2 / MOTOR DETAIL
Motor U/V/W + PE from X40 bus
Encoder to drive feedback input
Shield clamp near drive entry
Brake pair only on U44 Z axis

AXIS MAP
U41 X axis main gantry
U42 Y axis traverse
U43 ALT auxiliary axis
U44 Z axis with brake
U45 C axis spindle orient

ALARM / READY RETURN
Each drive ALM output -> R1-EC / NC300
DI group
ZSPD or ready used for servo healthy
chain
Common 0V reference on control side

CN1 SIGNALS
6 S-ON <- enable chain
29 STO1 / 30 STO2 <- Page 02 X11
36 ALM -> NC300 DI
37 ZSPD -> ready status
40 BRK -> only Z axis brake output
43 STO_COM common

# 05 R1-EC I/O

Bus coupler, DI/DO modulleri ve saha dagitimi

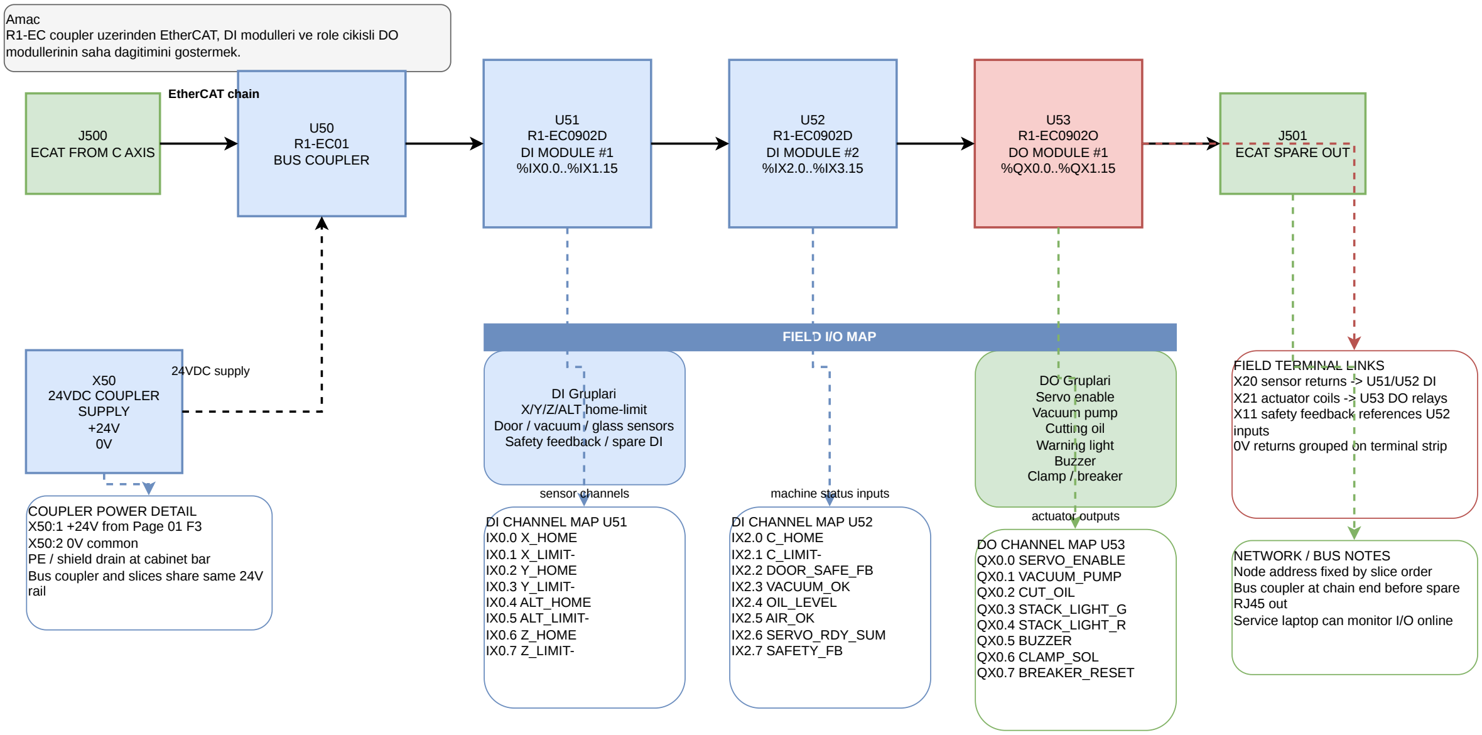
[picture p54: figure]
Amac; modullerinin saha dagitimini gostermek.; J500 ECAT FROM C AXIS; U50 R1-EC01 BUS COUPLER; U51 R1-EC0902D DI MODULE #1 %IX0.0..%IX1.15; U52 R1-EC0902D DI MODULE #2 %IX2.0..%IX3.15; U53 R1-EC0902O DO MODULE #1 %QX0.0..%QX1.15; J501 ECAT SPARE OUT; X50 24VDC COUPLER SUPPLY +24V 0V; DI Gruplari X/Y/Z/ALT home-limit Door / vacuum / glass sensors Safety feedback / spare DI; DO Gruplari Servo enable Vacuum pump Cutting oil Warning light Buzzer Clamp / breaker; FIELD I/O MAP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

R1-EC coupler uzerinden EtherCAT, DI modulleri ve role cikisli DO

PAGE 05 / REMOTE I-O

Rev A | Remote I/O slices, channel map and field links | Sheet 5 / 6

# 06 Terminal ve Pin Plani

Terminal, konnektor ve kritik pin ozetleri

Amac
Saha montaji ve baglanti kontrolu icin terminal ve kritik pin bilgilerini tek sayfada toplamak.

Kullanim
Bu sayfa saha kablolama kontrol listesi gibi okunabilir.

Pratik kural
Once terminal etiketi, sonra pin fonksiyonu, sonra renk ve ekran baglantisi kontrol edilir.

PAGE 06 / TERMINALS & PINS

Terminal Gruplari
X1 AC INPUT
X2 24V DISTRIBUTION
X10 SAFETY INPUTS
X11 STO OUTPUTS
X20 DI TERMINAL
X30 NC300 POWER
X31 NC300 FIELD I/O

M12 Sensor 4-pin
1 Brown +24V
2 White Output
3 Blue 0V
4 Black NO/NC Select

RJ45 EtherCAT
1 TX+
2 TX-3 RX+
6 RX-Shield -> PE

Servo CN1 kritikler
6 S-ON
29 STO1
30 STO2
36 ALM
37 ZSPD
38 POS
40 BRK
43 STO_COM

Servo CN2 encoder
1 +5V
2 /A
3 A
4 /B
5 B
6 Z

NC300 CN5 ozet
1 +24V_EXT
2-9 DI
10-17 DO
18 GND_I/O
19-26 AI
27-30 AO
31 GND_A
41-45 Shield GND

Renk Kodu
AC: BN / BK / GY / BU / GN-YE DC: RD +24V / BK 0V
Safety: YE
Sensor: Mavi tabanli saha kablosu

Shield / PE
Tum ekranlar tek noktadan PE barasina Motor ve encoder ekranlari ayri kelepce ile sonlandirilir

X20 SENSOR TERMINALS
1 X_HOME
2 X_LIMIT-3 Y_HOME
4 Y_LIMIT-5 ALT_HOME
6 ALT_LIMIT-7 Z_HOME
8 Z_LIMIT-9 C_HOME
10 C_LIMIT-

X21 ACTUATOR TERMINALS
1 SERVO_ENABLE
2 VACUUM_PUMP
3 CUT_OIL
4 STACK_LIGHT_G
5 STACK_LIGHT_R
6 BUZZER
7 CLAMP_SOL
8 BREAKER_RESET

DI QUICK REF
U51 IX0.0..0.7 -> home / limit set
U52 IX2.0..2.7 -> status / feedback set SAFETY_FB and SERVO_RDY_SUM are critical startup inputs

DO QUICK REF
U53 QX0.0..0.7 -> machine actuators Outputs are relay isolated
Inductive loads need suppression at field side

SERVO STATUS LINK
ALM outputs return to control DI group
ZSPD / ready chain supports startup permissive Z brake line must be checked separately

FIELD TERMINALS

CONTROL REFERENCES

TERMINAL GROUPS | FIELD CONNECTORS

CRITICAL DEVICE PINS

INSTALL CHECKLIST

1 AC giris ve PE surekliligi teyit edildi

2 24VDC polarite ve fuse cikislari dogrulandi

3 Safety reset, STO A/B ve feedback zinciri kontrol edildi

4 EtherCAT ve encoder ekranlari tek noktadan PE'ye baglandi

5 X20 home/limit sinyalleri I/O monitorunda dogrulandi

6 X21 actuator cikislari kuru test ile dogrulandi

Rev A | Terminal, connector and commissioning reference sheet | Sheet 6 / 6
