oktaycit/CNCRevizyon/CAD/GFB60:30RE-S.pdf

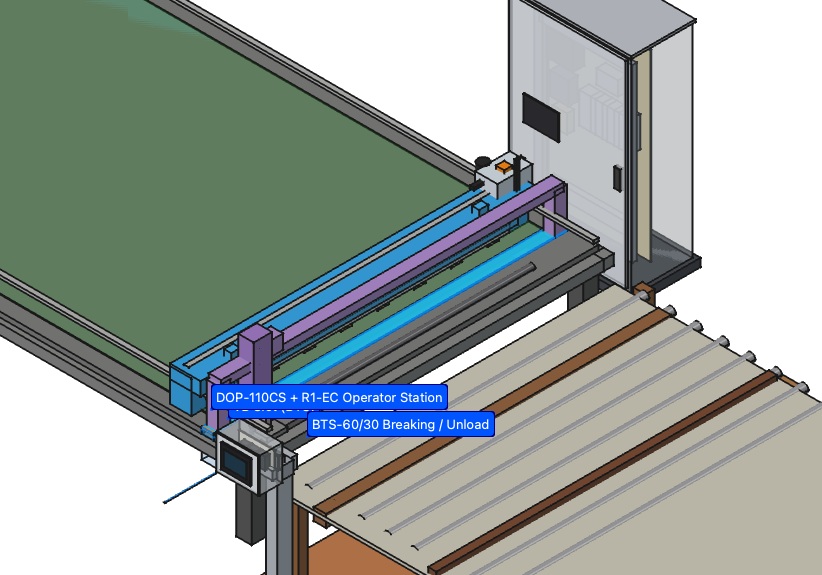
[picture p55: page 1]
