oktaycit/CNCRevizyon/(commit log)

2026-04-06 feat: update electrical schematics to rev 4.0, add technical manuals, and include project documentation and validation reports.
    [01_Ana_Guc_24VDC.kicad_sch, 02_Emniyet_STO.kicad_sch, 03_NC300_EtherCAT.kicad_sch, 04_Servo_Suruculer.kicad_sch, 05_R1EC_IO.kicad_sch, 06_Dijital_Girisler.kicad_sch, 07_Dijital_Cikislar.kicad_sch, 08_Terminal_Plani.kicad_sch]
2026-04-06 Remove obsolete Fritzing and KiCad schematic files
    [01_Ana_Guc_24VDC.kicad_sch, 02_Emniyet_STO.kicad_sch, 03_NC300_EtherCAT.kicad_sch, 04_Servo_Suruculer.kicad_sch, 05_R1EC_IO.kicad_sch, 06_Dijital_Girisler.kicad_sch, 07_Dijital_Cikislar.kicad_sch, 08_Terminal_Plani.kicad_sch]
2026-04-07 Refactor code structure for improved readability and maintainability
    [Cable_Gland_M40.stp, DOP-110CS_Housing.stp, DOP-110CS_Panel_Cutout.stp, IP65_Vent_Filter.stp, Operator_Terminal_Door.stp, Operator_Terminal_Enclosure.stp, R1-EC_Mounting_Plate.stp]
2026-04-11 Add wiring documentation for GFB60-30RE-S project
    - Created TERMINAL_TO_TERMINAL_LIST.md detailing terminal connections for 24VDC distribution, safety terminals, STO outputs, EtherCAT, servo and motor connections, DI and DO terminals.
    - Added WIRE_LIST_SAHA.md for comprehensive wire listing including power, servo, safety, EtherCAT, and sensor cables.
    - Introduced WIRING_SAHA_OZETI.md summarizing wiring overview, system topology, and detailed wiring connections for each axis and safety distribution.
    [sample_herofis_import.csv, sample_herofis_import_20260411_151044.csv, sample_herofis_import_20260411_151113.csv]
2026-04-11 Add detailed workflow for GFB-60/30RE panel replacement and revision process
    [auth.py, batch_processing.py, blade_management.py, database.py, dxf_import.py, gcode_generator.py, reports.py]
2026-04-13 Add G-code programs for arc testing and standard cutting operations
    - Created Arc_Test.nc for testing arc movements with G02 and G03 commands.
    - Developed Standard_Cut.nc for a standard cutting operation with specified material and tool details, including multiple cutting passes and tool movements.
    [30RE-S Hibrit Sistem.FCStd, BOM.csv, Cable_Carrier.stp, Cable_Gland_M40.stp, Cable_Schedule.csv, Connection_Matrix.csv, Control_Panel_Box.stp, CornerBracket.stp]
2026-04-13 Add FreeCAD macros and test scripts for CNC revision project
    - Created test script for FreeCAD MCP integration (test_freecad_mcp.py)
    - Added macro for creating parametric boxes (Macro_Box.py)
    - Added macro for creating parametric cylinders (Macro_Cylinder.py)
    - Developed assembly macro for Assembly4 workbench (Macro_Assembly4.py)
    - Implemented export functionality for STEP, DXF, STL, and PNG formats (Macro_Export.py)
2026-04-18 Add documentation and firmware updates for NC300 Lamine Clear Path functionality
    - Created FreeCAD Lamine Sync Simulation report detailing kinematics and collision findings.
    - Added FreeCAD NC300 Clear Path analysis report with model validation and clear path parameters.
    - Introduced Codex Usage Guide for efficient project management and documentation standards.
    - Implemented G-code for Lamine Clear Path operations, including probing, cutting, and heating sequences.
    - Developed Structured Text program for NC300 Lamine Clear Path control logic, ensuring safety interlocks and operational steps.
    - Updated README for NC300 ST resources, outlining file purposes and FreeCAD parameter mappings.
    [30RE-S Hibrit Sistem.FCStd]
2026-04-20 Add Dual Bridge System Revision Report and update related documentation
    - Created a comprehensive revision report for the Dual Bridge system, detailing the mechanical connection of the VB unit and the removal of unnecessary E-Cam programming.
    - Updated ST program and G-Code macros to reflect the new operational structure.
    - Enhanced the NC300 Programming Guide with explanations of the Dual Bridge system and the E-Cam usage status.
    - Revised FreeCAD Assembly README to include a table of axes and important notes regarding the Dual Bridge system.
    - Validated electrical schematics and updated the program architecture for the lamine cutting cycle.
    - Conducted a risk analysis and outlined next ste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
    [30RE CNC Assembly.FCStd, 30RE CNC Assembly4.FCStd, 30RE Tam Makine.FCStd, 30RE-S Hibrit Sistem.3mf, 30RE-S Hibrit Sistem.FCStd, Glass_Edge_Deletion_Head.FCStd, Glass_Edge_Deletion_Head.stp]
